SmokeTag/posture-monitoring-system/report/imt/capitulos/3metodologia.tex

\chapter{Metodologia}\label{cap:metodologia}

O sistema combina a orientação do alto das costas, medida pelo colar,
com o contato na cadeira. Esta decide o alerta e o devolve ao colar,
que vibra. O processamento independe do computador.

\section{Colar}
\label{sec:met-colar}

O colar contém uma placa XIAO nRF52840 Sense com IMU LSM6DS3TR-C
\cite{seeed_xiao,nordic_nrf52840,st_lsm6ds3trc}, posicionada nas costas,
abaixo do pescoço. Mede-se a orientação local, não a curvatura de toda a
coluna. Utiliza-se apenas o acelerômetro, com giroscópio desligado.
Das componentes $a_x$, $a_y$ e $a_z$, calculam-se \textit{pitch} ($p$)
e \textit{roll} ($r$), em graus:
\begin{equation}
 p=\frac{180}{\pi}\operatorname{atan2}\!\left(-a_x,\sqrt{a_y^2+a_z^2}\right),
 \qquad r=\frac{180}{\pi}\operatorname{atan2}(a_y,a_z).
 \label{eq:met-angulos}
\end{equation}
A estimativa usa a gravidade em condição aproximadamente estática
\cite{pedley2013}. Na montagem, $p$ é lateral (positivo à direita) e $r$,
sagital (negativo para a frente). Adquire-se e transmite-se a 20\,Hz;
movimento, deslocamento do colar e vibração podem alterar a medida.
Leituras inválidas inibem o alerta.

No circuito da Figura~\ref{fig:met-esquema-colar}, o transistor BC337
aciona o motor por modulação por largura de pulso (PWM), pois sua corrente
excede a de um pino lógico.
O diodo protege o chaveamento e o capacitor atenua o ruído. Durante os
pulsos de 700\,ms, separados por 300\,ms, transmite-se a última orientação
sem vibração, por até 1{,}5\,s. A Figura~\ref{fig:met-fluxo-colar}
sintetiza a aquisição e o controle.

\begin{figure}[H]
 \centering
 \caption{Esquema elétrico do colar.}
 \begin{SingleSpace}
 \begin{circuitikz}[font=\footnotesize, european resistors, line width=.6pt,
   pin/.style={font=\scriptsize,inner sep=2pt}]
  % XIAO do colar
  \draw[thick] (0,0) rectangle (3.8,4.0);
  \node[align=center,font=\footnotesize\bfseries] at (1.9,3.5) {XIAO nRF52840\\[-1pt] Sense};
  \draw[rounded corners=2pt] (0.45,1.45) rectangle (3.35,2.35);
  \node[align=center,font=\scriptsize] at (1.9,1.9) {IMU LSM6DS3TR-C\\(I\textsuperscript{2}C interno)};
  \node[align=center,font=\scriptsize] at (1.9,.6) {carregador\\LiPo / USB-C};
  \node[pin,anchor=west] at (0,2.7) {BAT+};
  \node[pin,anchor=west] at (0,1.0) {BAT$-$};
  \node[pin,anchor=east] at (3.8,2.9) {3V3};
  \node[pin,anchor=east] at (3.8,1.1) {D10};
  \node[pin,anchor=east] at (3.8,.4) {GND};
  % bateria
  \draw (0,2.7) to[spst,l_=S1] (-1.5,2.7) -- (-2.1,2.7) to[battery1] (-2.1,1.0) -- (0,1.0);
  \node[align=right,anchor=east,font=\scriptsize] at (-2.5,1.85) {LiPo 1S\\3{,}7\,V};
  % driver
  \node[npn,anchor=B] (Q) at (6.6,1.1) {};
  \node[font=\scriptsize,anchor=west] at (Q.text) {BC337};
  \draw (3.8,1.1) to[R,l={1\,k$\Omega$},-] (Q.B);
  \draw (Q.E) node[ground]{};
  % motor com diodo e capacitor em paralelo
  \coordinate (mb) at (Q.C |- 0,2.6);
  \coordinate (mt) at (Q.C |- 0,4.2);
  \draw (Q.C) -- (mb) to[Telmech=M] (mt);
  \draw ($(mb)+(1.2,0)$) to[D*,l_=1N4148] ($(mt)+(1.2,0)$); % cátodo no 3V3
  \draw ($(mt)+(3.1,0)$) to[C,l=33\,nF] ($(mb)+(3.1,0)$);
  \draw (mb) -- ++(3.1,0);
  \draw (3.8,2.9) -- (4.4,2.9) |- (mt) -- ++(3.1,0);
  \fill (mt) circle (1.4pt) ($(mt)+(1.2,0)$) circle (1.4pt)
        (mb) circle (1.4pt) ($(mb)+(1.2,0)$) circle (1.4pt);
  \node[font=\scriptsize,anchor=south] at (5.6,4.2) {3{,}3\,V};
  \node[font=\scriptsize,anchor=east] at ($(mb)!.5!(mt)+(-.45,0)$) {motor};
  \draw (3.8,.4) -- (4.4,.4) node[ground]{};
 \end{circuitikz}
 \end{SingleSpace}
 \fonte{Elaborado pelos autores (2026)}
 \label{fig:met-esquema-colar}
\end{figure}

\begin{figure}[H]
 \centering
 \caption{Fluxo de aquisição, controle e proteção do colar.}
 \begin{SingleSpace}
 \begin{tikzpicture}[
  b/.style={draw,rounded corners,align=center,font=\footnotesize,
    text width=3.55cm,minimum height=.78cm,inner sep=3pt},
  a/.style={-{Latex[length=1.7mm]},thick},
  n/.style={font=\footnotesize,fill=white,inner sep=1pt}]
  \node[b] (imu) at (0,0) {Ler IMU a 20\,Hz;\\reter leitura sem vibração};
  \node[b] (tx) at (4.65,0) {Enviar orientação;\\verificar ACK recebido};
  \node[b] (link) at (4.65,-1.8) {ACK de controle válido\\há menos de 1\,s?};
  \node[b] (local) at (0,-1.8) {Regra local, se calibrado:\\desvio $>10\degree{}$ por 3\,s};
  \node[b] (ack) at (9.3,-1.8) {Aplicar alerta do ACK\\se a IMU estiver válida};
  \node[b] (motor) at (4.65,-3.3) {Controlar motor\\e LED de estado};
  \node[b] (bat) at (4.65,-4.8) {Checar bateria;\\alimentar watchdog};
  \node[b] (off) at (9.3,-4.8) {Bateria baixa sem USB:\\motor e rádio OFF; desligar};
  \draw[a] (imu) -- (tx);
  \draw[a] (tx) -- (link);
  \draw[a] (link) -- node[n,above] {não} (local);
  \draw[a] (link) -- node[n,above] {sim} (ack);
  \draw[a] (local.south) |- (motor.west);
  \draw[a] (ack.south) |- (motor.east);
  \draw[a] (motor) -- (bat);
  \draw[a] (bat) -- node[n,above] {corte} (off);
  \draw[a] (bat.west) -- node[n,above] {continuar} (-2.45,-4.8) |- (imu.west);
 \end{tikzpicture}
 \end{SingleSpace}
 \fonte{Elaborado pelos autores (2026)}
 \label{fig:met-fluxo-colar}
\end{figure}

A alimentação usa LiPo 1S de 3{,}7\,V, chave S1 e recarga pelo USB-C
do XIAO; o invólucro comporta 1800\,mAh. Sem USB, três leituras abaixo de
3{,}30\,V desligam o colar; a partida exige 3{,}40\,V. O LED sinaliza
enlace, calibração, alerta e falha.

\section{Cadeira}
\label{sec:met-cadeira}

A segunda placa XIAO lê oito FSR402: quatro no assento (frente/trás,
esquerda/direita) e quatro no encosto (superior/inferior, esquerda/direita).
Sua resistência diminui com a força \cite{interlink_datasheet}; usam-se
as leituras como contato e distribuição relativa, sem conversão em força
absoluta na espuma.

O circuito da Figura~\ref{fig:met-esquema-cadeira} usa o multiplexador
CD74HC4067 \cite{ti_cd74hc4067} para ligar cada FSR ao resistor
compartilhado de 3{,}3\,k\ohm{} em SIG. Incluindo a resistência de
condução $R_{\mathrm{on}}$, a tensão lida em A0 é
\begin{equation}
 V_{\mathrm{SIG}}=V_{\mathrm{DD}}
 \frac{R_{\mathrm{fixo}}}{R_{\mathrm{fixo}}+R_{\mathrm{FSR}}+R_{\mathrm{on}}}.
 \label{eq:met-divisor}
\end{equation}
A tensão aumenta com a carga. O resistor aproxima
$\sqrt{R_{\min}R_{\max}}$ na faixa de contato, como compromisso entre
resolução e corrente; o efeito fixo de $R_{\mathrm{on}}$ é incorporado à
calibração. Os oito canais são lidos a 20\,Hz, com ADC de 12 bits.
O botão D9 solicita a calibração. A alimentação repete o circuito do colar.

\begin{figure}[H]
 \centering
 \caption{Esquema elétrico da cadeira.}
 \begin{SingleSpace}
 \begin{circuitikz}[font=\footnotesize, european resistors, line width=.6pt,
   pin/.style={font=\scriptsize,inner sep=2pt}]
  % multiplexador
  \draw[thick] (0,0) rectangle (5.4,2.9);
  \node[align=center,font=\footnotesize\bfseries] at (2.7,1.65) {CD74HC4067};
  \node[align=center,font=\scriptsize] at (2.7,1.2) {multiplexador 16:1};
  \foreach \i in {0,...,7} {
    \pgfmathtruncatemacro{\c}{\i+8}
    \coordinate (c\i) at (.55+.62*\i,2.9);
    \node[pin,anchor=north,font=\tiny] at (c\i) {C\c};
    \draw (c\i) to[R,resistors/scale=.65] ++(0,1.5) coordinate (t\i);
  }
  \node[font=\scriptsize,anchor=south] at ($(t3)!.5!(t4)+(0,.05)$) {8\,$\times$ FSR402};
  \draw (t0) -- (t7) -- ++(.9,0) coordinate (rail);
  \foreach \i in {0,...,6} \fill (t\i) circle (1.3pt);
  \node[pin,anchor=west] at (0,2.0) {VCC};
  \node[pin,anchor=west] at (0,.5) {EN};
  \node[pin,anchor=west] at (0,.15) {GND};
  \draw (0,2.0) -- (-.6,2.0) |- (t0);
   \draw (0,.5) -- (-.6,.5) -- (-.6,-.4) node[ground]{};
  \draw (0,.15) -- (-.6,.15);
  \fill (-.6,.15) circle (1.3pt);
  \foreach \n/\y in {S0/2.4,S1/1.95,S2/1.5,S3/1.05,SIG/.4}
    \node[pin,anchor=east] at (5.4,\y) {\n};
  % XIAO da cadeira
  \draw[thick] (8.9,-.8) rectangle (12.3,3.3);
  \node[align=center,font=\footnotesize\bfseries] at (10.85,2.55) {XIAO nRF52840\\[-1pt] Sense};
  \node[align=center,font=\scriptsize] at (10.9,.5) {carregador\\LiPo / USB-C};
  \foreach \n/\m/\y in {S0/D10/2.4,S1/D3/1.95,S2/D2/1.5,S3/D1/1.05} {
    \node[pin,anchor=west] at (8.9,\y) {\m};
    \draw (5.4,\y) -- (8.9,\y);
  }
  \node[pin,anchor=west] at (8.9,.4) {A0};
  \draw (5.4,.4) -- (8.9,.4);
  \fill (6.4,.4) circle (1.4pt);
  \draw (6.4,.4) to[R,l_={3{,}3\,k$\Omega$}] (6.4,-1.2) node[ground]{};
  \node[pin,anchor=north] at (9.3,3.3) {3V3};
  \draw (9.3,3.3) |- (rail);
  \node[font=\scriptsize,anchor=south] at (7.6,4.4) {3{,}3\,V};
  % botao e bateria
  \node[pin,anchor=east] at (12.3,2.2) {D9};
  \draw (12.3,2.2) -- (12.9,2.2) to[push button,l=calibrar] (12.9,.6) node[ground]{};
  \node[pin,anchor=south] at (9.6,-.8) {GND};
  \draw (9.6,-.8) -- (9.6,-1.2) node[ground]{};
  \node[pin,anchor=south] at (10.6,-.8) {BAT+};
  \node[pin,anchor=south] at (11.8,-.8) {BAT$-$};
  \draw (10.6,-.8) to[spst,l_=S1] (10.6,-2.2) to[battery1] (11.8,-2.2) -- (11.8,-.8);
  \node[font=\scriptsize,anchor=north] at (11.2,-2.55) {LiPo 1S, 3{,}7\,V};
 \end{circuitikz}
 \end{SingleSpace}
 \fonte{Elaborado pelos autores (2026)}
 \label{fig:met-esquema-cadeira}
\end{figure}

\section{Integração}
\label{sec:met-integracao}

A Figura~\ref{fig:met-arquitetura} reúne os blocos. O enlace Nordic
Enhanced ShockBurst (ESB), pela biblioteca \texttt{nrf\_to\_nrf}, usa
confirmação (ACK) e retransmissão
\cite{nordic_esb,tmrh20_nrftonrf}. A decisão da amostra $N$ retorna no ACK
de $N+1$. Após 1\,s sem ACK válido, o colar aplica a regra inercial
à última referência recebida; sem referência, não alerta.

\begin{figure}[H]
 \centering
 \caption{Arquitetura autônoma e interfaces de acompanhamento.}
 \begin{SingleSpace}
 \begin{tikzpicture}[
  b/.style={draw,rounded corners,align=center,font=\footnotesize,
   text width=3.4cm,minimum height=.8cm,inner sep=3pt},
  a/.style={-{Latex[length=1.7mm]},thick},
  n/.style={font=\footnotesize,align=center,fill=white,inner sep=2pt}]
  \node[b] (imu) at (0,0) {Acelerômetro\\LSM6DS3TR-C};
  \node[b] (body) at (4.65,0) {XIAO do colar\\aquisição e atuação};
  \node[b] (motor) at (9.3,0) {BC337 + motor\\retorno vibratório};
  \node[b] (fsr) at (0,-2.3) {8 FSR402\\+ CD74HC4067};
  \node[b] (chair) at (4.65,-2.3) {XIAO da cadeira\\calibração e fusão};
  \node[b] (pc) at (9.3,-2.3) {Painel \texttt{mostra.py}\\USB / beacon BLE};
  \draw[a] (imu) -- node[n,above] {I\textsuperscript{2}C} (body);
  \draw[a] (body) -- node[n,above] {PWM} (motor);
  \draw[a] (fsr) -- node[n,above] {ADC} (chair);
  \draw[a] (body.south west) -- node[n,left] {ESB: ângulos\\20\,Hz} (chair.north west);
  \draw[a] (chair.north east) -- node[n,right] {ACK: alerta\\e referência} (body.south east);
  \draw[a] (chair) -- (pc);
 \end{tikzpicture}
 \end{SingleSpace}
 \fonte{Elaborado pelos autores (2026)}
 \label{fig:met-arquitetura}
\end{figure}

A calibração individual é acionada com o usuário ereto, sentado ao fundo.
Em 20 amostras válidas (cerca de 1\,s), capturam-se as médias angulares
$p_0$, $r_0$ e a linha de base $b_i$ de cada FSR. Recusa-se a captura com
falha de IMU/enlace ou base traseira $B_T=b_{TE}+b_{TD}<1000$ contagens.
A referência é volátil e deve ser refeita após reinício ou recolocação.

Na fusão, $FE$, $FD$, $TE$ e $TD$ indicam frente/trás e esquerda/direita do
assento. O encosto é registrado e exibido, mas não decide o alerta, pois
pode ficar sem carga mesmo no ereto. Para leituras $f_i$, definem-se
\begin{equation}
 \begin{gathered}
 \Delta p=p-p_0,\quad \Delta r=r-r_0,\quad
 d=\sqrt{\Delta p^2+\Delta r^2},\\
 S=f_{FE}+f_{FD}+f_{TE}+f_{TD},\qquad
 \rho=\frac{f_{TE}+f_{TD}}{B_T},\\
 \ell=\frac{f_{FE}+f_{TE}-f_{FD}-f_{TD}}{S}
      -\frac{b_{FE}+b_{TE}-b_{FD}-b_{TD}}{\sum_{i\in\mathrm{assento}}b_i}.
 \end{gathered}
 \label{eq:met-indicadores}
\end{equation}
A razão $\rho$ mede o apoio traseiro relativo à referência; $\ell$, a
redistribuição lateral, positiva à esquerda. Para confirmar inclinação,
$h=\ell$ se $\Delta p<0$, ou $h=-\ell$ caso contrário; exige-se base
total do assento $\geq2000$ contagens. O teste de vazio precede as divisões.
Com $\Delta r>0$ e $\rho\geq0{,}7$, há reclinação apoiada: adota-se
$d_{\mathrm{ef}}=|\Delta p|$; nos demais casos, $d_{\mathrm{ef}}=d$.
Preserva-se assim a avaliação lateral sem alertar apenas por reclinar.
A Figura~\ref{fig:met-fusao} apresenta os testes e a persistência temporal;
são constantes de engenharia, não limites clínicos. Pernas cruzadas não
têm alerta específico; avaliam-se os desvios do tronco e o escorregamento.

Sem condição ruim, reinicia-se a contagem; na faixa de 7--10\degree{},
conserva-se o estado anterior. IMU inválida, assento vazio, perda de enlace
na cadeira e calibração aceita zeram o portão temporal. Sem USB, 10\,s de
assento vazio apagam a referência. O painel recebe o estado por USB ou
beacon BLE e exibe desvio, contato e alerta, sem participar da decisão.

\begin{figure}[H]
 \centering
 \caption{Prioridade da regra de fusão e encaminhamento ao portão temporal.}
 \begin{SingleSpace}
 \begin{tikzpicture}[y=1.12cm,
  q/.style={draw,align=center,font=\footnotesize,text width=5.3cm,
    minimum height=.65cm,inner sep=3pt},
  r/.style={draw,rounded corners,align=center,font=\footnotesize,
    text width=4.45cm,minimum height=.65cm,inner sep=3pt},
  a/.style={-{Latex[length=1.7mm]},thick},
  n/.style={font=\footnotesize,fill=white,inner sep=1pt}]
  \node[q] (invalid) at (0,0) {IMU inválida?};
  \node[q] (empty) at (0,-1.05) {$S<2000$ contagens?};
  \node[q] (slump) at (0,-2.1) {$\rho<0{,}3$?};
  \node[q] (dev) at (0,-3.15) {$d_{\mathrm{ef}}>10\degree{}$?};
  \node[q] (lean) at (0,-4.2) {Base lateral válida, $|\Delta p|\geq5\degree{}$\\e $h\geq0{,}08$?};
  \node[q] (ok) at (0,-5.35) {\texttt{RECLINE\_OK} se reclinado e $d>10\degree{}$;\\\texttt{OK} nos demais casos};
  \node[r] (ri) at (7.2,0) {\texttt{INVALID}: zerar portão};
  \node[r] (re) at (7.2,-1.05) {\texttt{EMPTY}: zerar portão};
  \node[r] (rs) at (7.2,-2.1) {\texttt{SLUMP}: condição ruim};
  \node[r] (rd) at (7.2,-3.15) {\texttt{IMU\_DEV}: condição ruim};
  \node[r] (rl) at (7.2,-4.2) {\texttt{LEAN}: condição ruim};
  \node[r] (gate) at (7.2,-5.35) {Portão: ruim por 3\,s dispara;\\sem condição ruim e $d_{\mathrm{ef}}<7\degree{}$ limpa};
  \foreach \x/\y in {invalid/empty,empty/slump,slump/dev,dev/lean,lean/ok}
    \draw[a] (\x) -- node[n,right] {não} (\y);
  \foreach \x/\y in {invalid/ri,empty/re,slump/rs,dev/rd,lean/rl}
    \draw[a] (\x) -- node[n,above] {sim} (\y);
  \draw[a] (ok) -- (gate);
  \draw[a] (rs.east) -- ++(.5,0) |- (gate.east);
  \draw (rd.east) -- ++(.5,0); \draw (rl.east) -- ++(.5,0);
 \end{tikzpicture}
 \end{SingleSpace}
 \fonte{Elaborado pelos autores (2026)}
 \label{fig:met-fusao}
\end{figure}
