SmokeTag/posture-monitoring-system/report/imt/pretextual/capa.tex

% ---
% Impressão da Capa
% ---
  \begin{capa}%
    \center
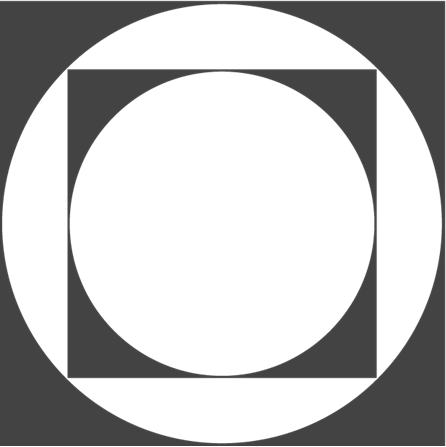
[picture p1: report/imt/images/logo_IMT_preto_1.png]
     \\
	{\fontfamily{ptm}\selectfont
        \ABNTEXchapterfont\large{CENTRO UNIVERSITÁRIO DO INSTITUTO MAUÁ DE TECNOLOGIA \\
                                        Engenharia de Controle e Automação}
    }
	
    \vspace{1cm}
    {\fontfamily{ptm}\selectfont
        \LARGE{Sistema inteligente de monitoramento postural com cadeira instrumentada e colar inercial}
    }
    \vspace{1cm}
    
    %%%%%%%%%%%%%%%%% INFORMAÇÕES SOBRE AUTOR PRINCIPAL %%%%%%%%%%%%%%%%%%%%%%%%%%%%%%%
    {\fontfamily{ptm}\selectfont
        \begin{flushright}
            \normalsize{André Thomas Monteiro} \\
            \normalsize{\pendente{demais integrantes do grupo}} \\
            \normalsize{Orientadora: Profa. \pendente{titulação} Andressa \pendente{sobrenome}} \\
        \end{flushright}
    }
    \vspace{0.2cm}

    %%%%%%%%%%%%%%%%%%%%%%%%%%%%%%%% RESUMO %%%%%%%%%%%%%%%%%%%%%%%%%%%%%%%
    
    \setlength{\absparsep}{18pt} % ajusta o espaçamento dos parágrafos do resumo
    \begin{abstract}
        \noindent
        \input{pretextual/resumo_pt}
    \end{abstract}

\end{capa}
% ---
