SmokeTag/posture-monitoring-system/report/imt/main.tex

% ---------------------------------------------------------------------------
% ---------------------------------------------------------------------------
% Modelo LaTex para preparação do documento final de Monografia TCC
% O modelo em conformidade com ABNT NBR
% IMT
% ---------------------------------------------------------------------------
% ---------------------------------------------------------------------------

\documentclass[
	% -- opções da classe memoir --
	12pt,					% tamanho da fonte
	openright,				% capítulos começam em pág ímpar (insere página vazia caso preciso)
	oneside,					% para impressão em verso e anverso. Oposto a oneside
	a4paper,					% tamanho do papel. 
	% -- opções da classe abntex2 --
	%chapter=TITLE,			% títulos de capítulos convertidos em letras maiúsculas
	%section=TITLE,			% títulos de seções convertidos em letras maiúsculas
	%subsection=TITLE,		% títulos de subseções convertidos em letras maiúsculas
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
\usepackage[alf]{abntex2cite}				% Citações padrão ABNT (alfa)

%\usepackage[num]{abntex2cite}				% Citações padrão ABNT (numericas)
% ---------------------
\usepackage{float}
% Configurações de CITAÇÕES para abntex2
%\include{extras/conf_citacoes}

% Inclui Configurações de aparência do PDF Final
\include{extras/conf_pdf}

% O tamanho da identação do parágrafo é dado por:
\setlength{\parindent}{0cm}
\setlength{\parskip}{0.2cm} 
% Controle do espaçamento entre um parágrafo e outro:
\setlength{\parskip}{0.2cm}  % tente também \onelineskip

% Ajusta o espaçamento após \chapter
\setlength\afterchapskip{\lineskip}

\setlist[itemize]{leftmargin=1.25cm}
\setlist[enumerate]{leftmargin=1.25cm}
\usepackage{listings}
\usepackage{framed}
\usepackage{color} %use color
\definecolor{mygreen}{rgb}{0,0.6,0}
\definecolor{mygray}{rgb}{0.5,0.5,0.5}
\definecolor{mymauve}{rgb}{0.58,0,0.82}
 
%Customize a bit the look.
\lstset{ %
backgroundcolor=\color{white}, % choose the background color; you must add \usepackage{color} or \usepackage{xcolor}
basicstyle=\footnotesize, % the size of the fonts that are used for the code
breakatwhitespace=false, % sets if automatic breaks should only happen at whitespace
breaklines=true, % sets automatic line breaking
captionpos=b, % sets the caption-position to bottom
commentstyle=\color{mygreen}, % comment style
deletekeywords={...}, % if you want to delete keywords from the given language
escapeinside={\%*}{*)}, % if you want to add LaTeX within your code
extendedchars=true, % lets you use non-ASCII characters; for 8-bits encodings only, does not work with UTF-8
frame=single, % adds a frame around the code
keepspaces=true, % keeps spaces in text, useful for keeping indentation of code (possibly needs columns=flexible)
keywordstyle=\color{blue}, % keyword style
% language=Octave, % the language of the code
morekeywords={*,...}, % if you want to add more keywords to the set
numbers=left, % where to put the line-numbers; possible values are (none, left, right)
numbersep=5pt, % how far the line-numbers are from the code
numberstyle=\tiny\color{mygray}, % the style that is used for the line-numbers
rulecolor=\color{black}, % if not set, the frame-color may be changed on line-breaks within not-black text (e.g. comments (green here))
showspaces=false, % show spaces everywhere adding particular underscores; it overrides 'showstringspaces'
showstringspaces=false, % underline spaces within strings only
showtabs=false, % show tabs within strings adding particular underscores
stepnumber=1, % the step between two line-numbers. If it's 1, each line will be numbered
stringstyle=\color{mymauve}, % string literal style
tabsize=2, % sets default tabsize to 2 spaces
title=\lstname % show the filename of files included with \lstinputlisting; also try caption instead of title
}
%END of listing package%
 
\definecolor{darkgray}{rgb}{.4,.4,.4}
\definecolor{purple}{rgb}{0.65, 0.12, 0.82}
 
%define Javascript language
\lstdefinelanguage{JavaScript}{
keywords={typeof, new, true, false, catch, function, return, null, catch, switch, var, if, in, while, do, else, case, break},
keywordstyle=\color{blue}\bfseries,
ndkeywords={class, export, boolean, throw, implements, import, this},
ndkeywordstyle=\color{darkgray}\bfseries,
identifierstyle=\color{black},
sensitive=false,
comment=[l]{//},
morecomment=[s]{/*}{*/},
commentstyle=\color{purple}\ttfamily,
stringstyle=\color{red}\ttfamily,
morestring=[b]',
morestring=[b]"
}
 
\lstset{
language=JavaScript,
extendedchars=true,
basicstyle=\footnotesize\ttfamily,
showstringspaces=false,
showspaces=false,
numbers=left,
numberstyle=\footnotesize,
numbersep=9pt,
tabsize=2,
breaklines=true,
showtabs=false,
captionpos=b,
aboveskip=30pt,
belowskip=0pt,
}

% ---------------------
% Compila o indice
% ---------------------
\makeindex
% ---------------------

%%%%%%%%%%%%%%%%%%%%%%%%%%%
%%  INICIO DO DOCUMENTO  %%
%%%%%%%%%%%%%%%%%%%%%%%%%%%
\begin{document}

% Retira espaço extra obsoleto entre as frases.
\frenchspacing

% ----------------------------------------------------------
% ELEMENTOS PRÉ-TEXTUAIS (Capa, Resumo, Abstract, etc.)
% ----------------------------------------------------------
\pretextual

% Elementos textuais com numeração arábica
\pagenumbering{arabic}

% Capa
\input{pretextual/capa}
\clearpage

% Resumo e Abstract
\input{pretextual/resumos}
\clearpage

% ----------------------------------------------------------
% ELEMENTOS TEXTUAIS (Capítulos)
% ----------------------------------------------------------
\textual

% Reinicia a contagem do número de páginas
\setcounter{page}{3}

% Inclui cada capitulo da Dissertação
\begingroup
    \selectlanguage{brazil}
    \renewcommand{\fontename}{Fonte} % o abstract em inglês deixa "Source"

    \renewcommand{\cleardoublepage}{}
    \renewcommand{\clearpage}{}
    
    \input{capitulos/1introducao}

    \renewcommand{\cleardoublepage}{}
    \renewcommand{\clearpage}{}
    
    \input{capitulos/2revisao_bibliografica}

    \renewcommand{\cleardoublepage}{}
    \renewcommand{\clearpage}{}
    
    \input{capitulos/3metodologia}

    \renewcommand{\cleardoublepage}{}
    \renewcommand{\clearpage}{}
    
    \input{capitulos/4resultados}

    \renewcommand{\cleardoublepage}{}
    \renewcommand{\clearpage}{}
    
    \input{capitulos/5conclusao}

\endgroup

% ----------------------------------------------------------
% ELEMENTOS PÓS-TEXTUAIS (Referências, Glossário, Apêndices)
% ----------------------------------------------------------
%\postextual

% Referências bibliográficas
\selectlanguage{brazil}
\bibliography{bibliografia}

\end{document}
