SmokeTag/posture-monitoring-system/data/archive/README.md

# Archive — midterm captures (June 2026)

> **Archived.** Midterm captures behind the partial report: the IMU
> run used a bare XIAO taped to the back (no enclosure, no neck mount) and the
> FSR402 runs a bench rig. Superseded by the full-system captures in `../`;
> kept as-is for the final report.

# Capture data — IMU posture runs

Raw serial captures from `firmware/archive/xiao_imu_test/xiao_imu_test.ino`. One CSV per
capture run. The procedure that produces these files:
[`../../docs/archive/protocolo-captura-imu.md`](../../docs/archive/protocolo-captura-imu.md).

## File naming

```
YYYY-MM-DD_<subject>_<mount>_<chair>.csv
```

- `subject` — short name (e.g. `andre`)
- `mount` — `no-neck-mount` (bare XIAO strapped on) or `neck-mount`
- `chair` — `own-chair`, `office-chair-A`, …
- Add `-run2`, `-run3` if more than one capture in a day with the same setup.

The analysis scripts default to the **newest** file here (ISO dates sort
chronologically); override with `--csv data/archive/<file>.csv`.

## Schema

`t_ms,tag,cal,pitch,roll,dpitch,droll,ax,ay,az,gx,gy,gz` — see
[`../../analysis/archive/postures.py`](../../analysis/archive/postures.py) for full column docs.

Tag map: `0` upright · `1` forward slouch · `2` lean left · `3` lean right ·
`4` head-down · `5` laid-back · `9` transition/moving (dropped in
analysis). `#`-prefixed lines are comments (calibration events, tag stamps).

## Run registry

| run | file | date | subject | mount | chair | notes |
|----:|---|---|---|---|---|---|
| 1 | `2026-06-19_andre_no-neck-mount_own-chair.csv` | 2026-06-19 | André Thomas Monteiro | none (bare XIAO) | own office chair | 6 postures × 5 rounds + 7 re-don calibrations. Validated **15 PASS / 3 WARN / 0 FAIL** (`../../analysis/archive/VALIDATION.md`). Postures performed *pronounced* → separation is optimistic. First calibration was an immediate double-press. |

# Capture data — FSR402 characterization (Campaign B)

Raw serial captures from `firmware/archive/uno_fsr_test/uno_fsr_test.ino` (Arduino Uno,
single FSR402 on a voltage divider). Procedure:
[`../../docs/archive/protocolo-fsr-balanca-precisao.md`](../../docs/archive/protocolo-fsr-balanca-precisao.md)
(precision-balance light-contact variant).

## File naming

```
YYYY-MM-DD_<sensor>_<subject>_<rfixed-ohms>_<kind>.csv
```

- `sensor` — which physical FSR402 part: `fsr` (unit 1), `fsr2`, `fsr3`, … —
  distinct sensors, for part-to-part spread.
- `rfixed-ohms` — measured divider resistor (e.g. `2833` = 2.833 kΩ measured).
- `kind` — `sweep` / `sweep2…` (R-vs-load up+down) or `creepNkg` (R-vs-time at a
  constant N-kg dead load).

## Schema

`t_ms,load_kg,raw,ohms` — `ohms = -1` means open / no force. **Units caveat:**
the column is named `load_kg` but the precision-balance runs stamp it in
**GRAMS** (`50`, `100`, … `2000`). The analysis scripts take `--units g` to
normalize. `#`-prefixed lines are comments (the CSV header, tag stamps).

## Run registry

| run | file | date | subject | R_fixed | kind | units | notes |
|----:|---|---|---|---:|---|---|---|
| B1 | `2026-06-19_fsr_andre_2833_sweep.csv` | 2026-06-19 | André Thomas Monteiro | 2833 Ω (measured) | sweep (up+down) | grams | 18 load levels 10→2004 g, ~20k loaded samples. R 4467→173 Ω; near-flat by ~1.2–1.6 kg (knee within the 2 kg cap — full saturation needs a bigger scale). **Corrected:** a ~0.3 s contact spike in the 670 g block (`t_ms` 827253–827456, ohms→613/621) was zeroed; rest of the block is clean ~314 Ω. |
| B2 | `2026-06-19_fsr_andre_2833_sweep2.csv` | 2026-06-19 | André Thomas Monteiro | 2833 Ω (measured) | sweep2 (repeat) | grams | Clean ladder 50→2002 g, ~12.6k samples. R 4134→180 Ω. Floor agrees with B1 (173 vs 180 Ω) → good repeatability. |
| B3 | `2026-06-19_fsr_andre_2833_creep1kg.csv` | 2026-06-19 | André Thomas Monteiro | 2833 Ω (measured) | creep @ 1 kg | grams | ~11 min constant 1 kg dead load. **Creep −7.4% (292→270 Ω, −0.67 %/min)**, most drift in first ~4 min. Lift-off tail at the end (still stamped 1000) excluded by the per-bin median. |
| B4 | `2026-06-19_fsr2_andre_2833_sweep.csv` | 2026-06-19 | André Thomas Monteiro | 2833 Ω (measured) | sweep (up+down), **2nd FSR** | grams | 10 levels 50→2000 g. R 3034→158 Ω. Floor agrees with FSR1 (158 vs 173/180 Ω). Part-to-part vs FSR1: ~20–40 % at the light end, ~5–10 % at the floor. **Corrected:** 17 up-sweep samples mis-stamped 100 g (`t_ms` 262993–264614, ~287 Ω — really a 1000 g reading with a dropped zero) were zeroed (load→0) to exclude them, leaving the real 100 g and 1000 g levels untouched. |
| B5 | `2026-06-19_fsr2_andre_2833_creep1kg.csv` | 2026-06-19 | André Thomas Monteiro | 2833 Ω (measured) | creep @ 1 kg, **2nd FSR** | grams | **~12 min @ 1 kg** (7118 loaded samples; `validate_fsr` PASS). Creep **−11.5 % (253→224 Ω, −0.95 %/min)** — FSR2 drifts *more* than FSR1 (B3 −7.4 %), not less. The earlier "−5.1 % / 240 Ω" was the *2-min-bin* value mistaken for the whole run. |
| B6 | `2026-06-19_fsr3_andre_2833_sweep.csv` | 2026-06-19 | André Thomas Monteiro | 2833 Ω (measured) | sweep (up+down), **3rd FSR** | grams | **Recapture of the old VOID** — now truly loaded (raw→972, floor 158 Ω). USABLE with a caveat: the light-end **up-sweep is a seating transient** (400 g up≈9 kΩ *settling* vs down 812 Ω; `validate_fsr.py` flags 600 g, up/down ×5). Trust its down-sweep / heavy end; use B7 for the clean curve. |
| B7 | `2026-06-19_fsr3_andre_2833_sweep2.csv` | 2026-06-19 | André Thomas Monteiro | 2833 Ω (measured) | sweep2 (repeat), **3rd FSR** | grams | **CLEAN** (`validate_fsr.py`: 13 PASS / 0 WARN). Well-seated 200→2001 g, R 1164→173 Ω. Floor 173 Ω agrees with FSR1/FSR2 → the **N=3 part-to-part point**. |

> **(Resolved)** The earlier *"FSR3 is VOID"* note was the first botched FSR3 try
> (puck not transferring force). FSR3 was **recaptured** into B6/B7 above; B7 is
> clean. Run `validate_fsr.py` on any new capture before trusting it.

Cross-run findings (floor, part-to-part, seating, hysteresis, model,
resolution): [`../../analysis/archive/FSR_FINDINGS.md`](../../analysis/archive/FSR_FINDINGS.md).
Tooling: [`../../analysis/archive/README.md`](../../analysis/archive/README.md).
