SmokeTag/posture-monitoring-system/docs/stand/dashboard-alerta.png

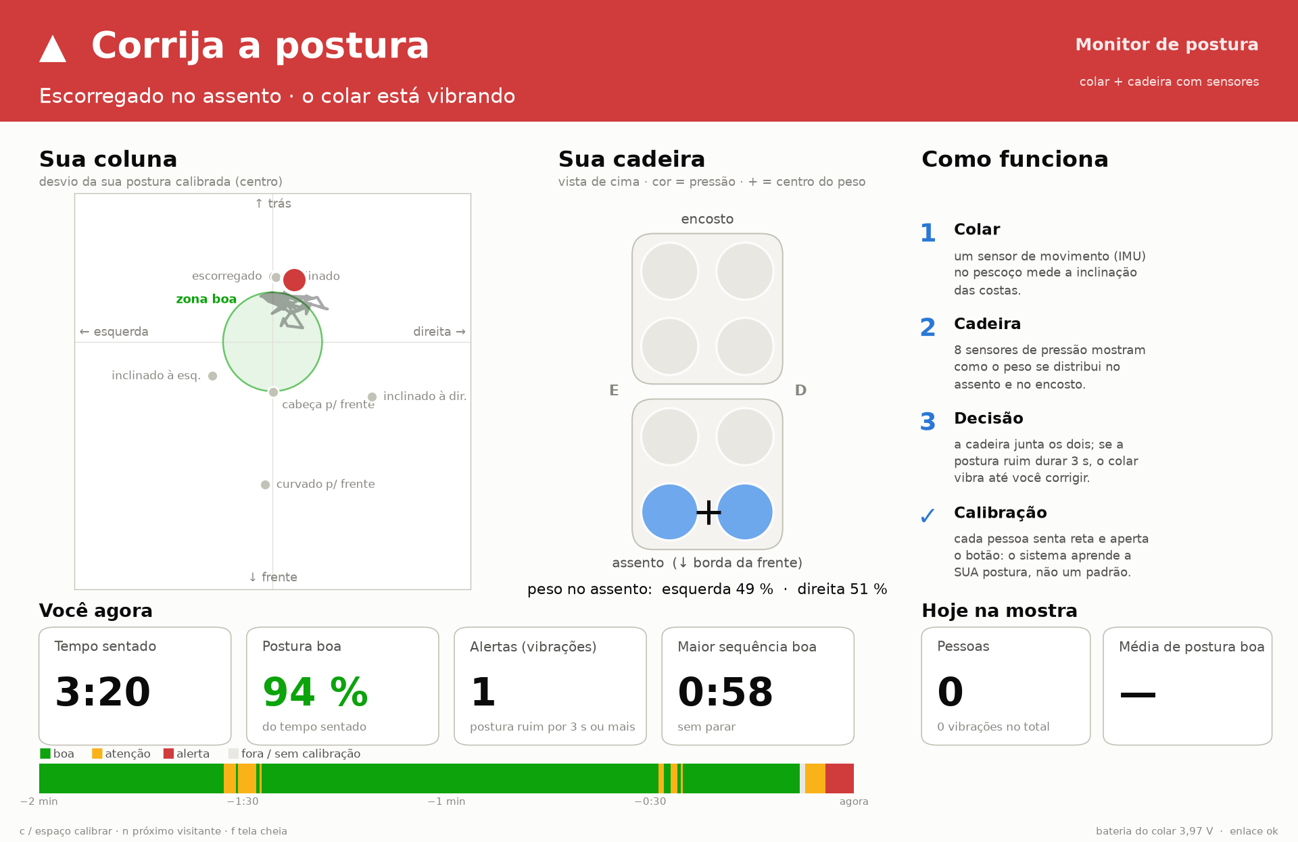
docs/stand/dashboard-alerta.png
