SmokeTag/posture-monitoring-system/docs/stand/dashboard-boa.png

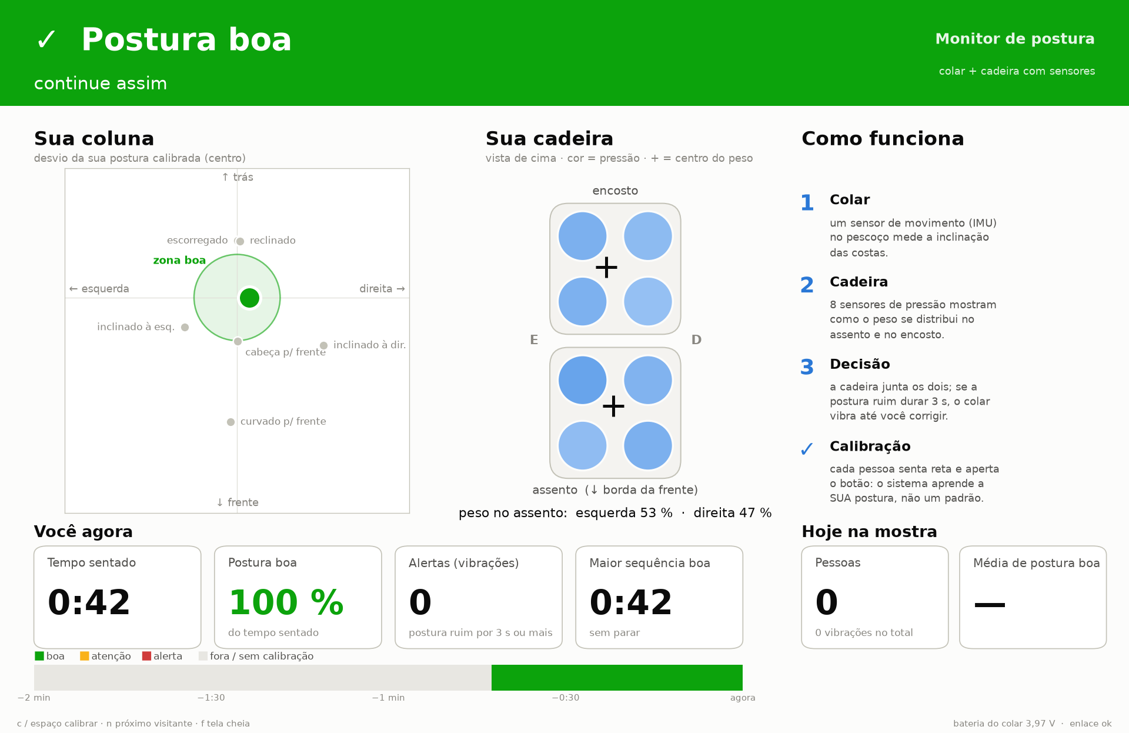
docs/stand/dashboard-boa.png
