SmokeTag/posture-monitoring-system/data/validation/2026-10-22_Andre-Monteiro_run1.csv

# validation session: Andre-Monteiro; firmware=c4ae8f2; motor active; guided hardware test; collar/chair details pending
# tag map 0=transition 1=ereto 2=curvado_frente 3=cabeca_frente 4=escorregado 5=inclinado_esq 6=inclinado_dir 7=reclinado 8=perna_e_sobre_d 9=perna_d_sobre_e
# fsr map c8=seat_front_left c9=seat_front_right c10=seat_rear_left c11=seat_rear_right c12=back_lower_right c13=back_upper_right c14=back_lower_left c15=back_upper_left
# chair unit (brain): FSRs C8..C15 + body IMU. 'c'/button = calibrate | 'r' = clear | 'm' = motor test
# unit=raw
t_ms | cal | calid | dev | alert | dpitch | droll | pitch | roll | boot | seq | bctl | bcal | bcalid | balert | bmotor | btest | bseq | bage | imu | binh | vbat | c8 | c9 | c10 | c11 | c12 | c13 | c14 | c15 | reason | tag
# proto=4
65912 | 0 | 247 | 0.0 | 0 | 2.2 | 1.3 | 2.2 | 1.3 | 231 | 1575 | 1 | 0 | 247 | 0 | 0 | 0 | 1573 | 2 | 0 | 0 | 4044 | 0 | 0 | 0 | 0 | 1 | 0 | 0 | 0 | -1 | 0
65961 | 0 | 247 | 0.0 | 0 | 2.2 | 1.3 | 2.2 | 1.3 | 231 | 1576 | 1 | 0 | 247 | 0 | 0 | 0 | 1574 | 2 | 0 | 0 | 4044 | 0 | 0 | 2 | 0 | 0 | 4 | 0 | 0 | -1 | 0
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
