SmokeTag/posture-monitoring-system/analysis/test_live_posture.py

"""Tests for live_posture.py's CSV parsing and body-status logic (no board,
no window). The main test feeds it the real chair firmware's output: the
two-board system test (firmware/test/test_system: chair.ino + body.ino on host
stubs) is built and run, and its chair serial stream is parsed line by line.

    QT_QPA_PLATFORM=offscreen .venv/bin/python -m unittest discover -s analysis
"""

from __future__ import annotations

import subprocess
import tempfile
import unittest
from pathlib import Path
from unittest.mock import Mock, patch

import numpy as np

import captures as C
import live_posture as LP

ROOT = Path(__file__).resolve().parent.parent
TESTS = ROOT / "firmware" / "test"

# firmware v1 (before the body's report): column line + rows, as captured
V1_HEADER = "t_ms,cal,dev,alert,led,dpitch,droll,pitch,roll,seq,c8,c9,c10,c11,c12,c13,c14,c15"
V1_ROWS = [
    "1000,1,3.2,0,0,1.0,-3.0,5.0,2.0,41,-1,-1,5400,-1,-1,-1,-1,-1",
    "1050,1,12.5,1,1,12.0,-3.5,16.0,1.5,42,-1,-1,5410,-1,-1,-1,-1,-1",
    "1100,0,0.0,0,0,0.0,0.0,0.0,0.0,-1,-1,-1,-1,-1,-1,-1,-1,-1",
]
V2_FIELDS = ("t_ms,cal,calid,dev,alert,dpitch,droll,pitch,roll,boot,seq,"
             "bctl,bcal,bcalid,balert,bmotor,btest,bseq,bage").split(",")


def reader() -> LP.ChairReader:
    return LP.ChairReader("/dev/null", None, trail_n=60)


def feed(r: LP.ChairReader, lines):
    for line in lines:
        r._handle(line)


def row(seq, *, boot=0x5a, cal=1, calid=7, alert=0, bctl=1, bcal=1, bcalid=7, balert=0,
        bmotor=0, btest=0, bseq=None, bage=2):
    """A v2 row dict; bseq defaults to seq - bage."""
    if bseq is None:
        bseq = (seq - bage) & 0xFFFF if bage >= 0 else -1
    return dict(t_ms=0, cal=cal, calid=calid, dev=0, alert=alert, dpitch=0, droll=0, pitch=0,
                roll=0, boot=boot, seq=seq, bctl=bctl, bcal=bcal, bcalid=bcalid, balert=balert,
                bmotor=bmotor, btest=btest, bseq=bseq, bage=bage)


class Connection(unittest.TestCase):
    def test_header_survives_open_and_reconnect_without_commands(self):
        class Port:
            def __init__(self, **kwargs):
                self.is_open, self._dtr = False, True
                self.lines, self.actions = [], []

            @property
            def dtr(self):
                return self._dtr

            @dtr.setter
            def dtr(self, value):
                self._dtr = value
                self.actions.append(("dtr", value))
                if self.is_open and value:
                    self.lines.append("# unit=raw")

            def open(self):
                self.is_open = True
                self.actions.append(("open", self.dtr))
                if self.dtr:
                    self.lines.append("# unit=raw")
                self.lines.clear()                   # pyserial's input flush during open
                self.lines.append("stale previous header")  # USB bytes arriving after that flush

            def reset_input_buffer(self):
                self.actions.append(("flush", self.dtr))
                self.lines.clear()

            def close(self):
                self.is_open = False

            def write(self, value):
                raise AssertionError("opening the port must not send commands")

        r = reader()
        with patch.object(LP.serial, "Serial", side_effect=Port), patch.object(LP.time, "sleep") as sleep:
            for _ in range(2):                      # opening and reconnecting use the same handshake
                port = r._open_port()
                self.assertEqual(port.port, r.port)
                self.assertEqual(port.actions, [("dtr", False), ("open", False),
                                                ("flush", False), ("dtr", True)])
                self.assertEqual(port.lines, ["# unit=raw"])
                port.close()
            self.assertEqual(sleep.call_count, 2)

    def test_failed_open_closes_port(self):
        port = Mock()
        port.open.side_effect = LP.serial.SerialException("device disappeared")
        with patch.object(LP.serial, "Serial", return_value=port):
            with self.assertRaises(LP.serial.SerialException):
                reader()._open_port()
        port.close.assert_called_once()


    def test_motor_muted_sends_q_on_every_connection(self):
        """--motor-muted: 'q' right after each (re)connection (the chair
        unmutes whenever the port closes); without it, nothing is sent."""
        class Stop(Exception):
            pass

        for muted, expected in ((True, [b"q", b"q"]), (False, [])):
            writes = []

            class Port:
                def __enter__(self):
                    return self

                def __exit__(self, *exc):
                    return False

                def write(self, value):
                    writes.append(value)

                def readline(self):
                    raise LP.serial.SerialException("unplugged")

            r = LP.ChairReader("/dev/null", None, trail_n=60, motor_muted=muted)
            with patch.object(r, "_open_port", side_effect=lambda: Port()), \
                    patch.object(LP.time, "sleep", side_effect=[None, Stop()]):
                with self.assertRaises(Stop):
                    r.run()
            self.assertEqual(writes, expected)


class MotorMute(unittest.TestCase):
    """The motor line with the body's bmute report (protocol v5)."""

    def motor(self, **kw):
        r = row(100)
        r.update(kw)
        return LP.body_lines([r])[2]

    def test_lines(self):
        self.assertEqual(self.motor(bmute=1), "motor   ○ mudo")
        self.assertEqual(self.motor(bmute=1, bmotor=1, balert=1), "motor   ○ mudo (teria vibrado)")
        self.assertEqual(self.motor(bmute=1, bmotor=1, btest=1), "motor   ● teste")   # really buzzes
        self.assertEqual(self.motor(bmute=0, bmotor=1, balert=1), "motor   ● alerta")
        self.assertEqual(self.motor(bmotor=1, balert=1), "motor   ● alerta")          # v4: no bmute


class RealFirmwareStream(unittest.TestCase):
    """The chair stream of firmware/test/test_system, through ChairReader."""

    @classmethod
    def setUpClass(cls):
        subprocess.run(["make", "-s", "-C", str(TESTS), "test_system"], check=True,
                       capture_output=True)
        with tempfile.TemporaryDirectory() as d:
            chair, body = Path(d) / "chair.out", Path(d) / "body.out"
            subprocess.run([str(TESTS / "test_system"), str(chair), str(body)], check=True,
                           capture_output=True)
            cls.lines = chair.read_text().splitlines()

    def test_header_drives_columns(self):
        r = reader()
        feed(r, self.lines)
        self.assertEqual(r.fields, V2_FIELDS + ["imu", "binh", "vbat"])
        self.assertTrue(r.rows)
        self.assertEqual(len(r.fsr[-1][1]), 8)          # c8..c15 found after the new columns

    def test_every_body_report_confirms(self):
        """Replays the stream; at every row the status is computed as the
        live view would. The system is consistent, so: never "≠"; ✓ in steady
        chair control; fallback and unknown bases never count as a mismatch."""
        r = reader()
        seen = {"✓ aplicado": 0, "não conferido": 0, "SOZINHO": 0, "≠ aplicado": 0}
        for line in self.lines:
            n0 = len(r.rows)
            last = r.rows[-1] if r.rows else None
            r._handle(line)
            if not r.rows or (len(r.rows) == n0 and r.rows[-1] is last):
                continue
            text = " ".join(LP.body_lines(list(r.rows))[:2])
            for k in seen:
                seen[k] += k in text
        self.assertEqual(seen["≠ aplicado"], 0)
        self.assertGreater(seen["✓ aplicado"], 200)
        self.assertGreater(seen["SOZINHO"], 50)
        self.assertGreater(seen["não conferido"], 0)       # e.g. the chair's no-basis ACK

    def test_motor_test_is_not_an_alert(self):
        r = reader()
        tested = False
        for line in self.lines:
            r._handle(line)
            if r.rows and r.rows[-1].get("btest") == 1:
                self.assertEqual(LP.body_lines(list(r.rows))[2], "motor   ● teste")
                self.assertEqual(r.rows[-1]["balert"], 0)
                tested = True
        self.assertTrue(tested)


    def test_log_gets_the_tag_column(self):
        """The logged stream reads back as one table with a trailing tag column,
        holding the tag in effect when each row arrived (0 until one is set)."""
        with tempfile.TemporaryDirectory() as d:
            path = Path(d) / "run.csv"
            r = LP.ChairReader("/dev/null", path, trail_n=60)
            r.note("tag map 0=transition 1=upright")
            half = len(self.lines) // 2
            feed(r, self.lines[:half])
            r.tag = 3
            feed(r, self.lines[half:])
            r.log.close()
            table = [ln.split(",") for ln in path.read_text().splitlines()
                     if not ln.startswith("#")]
        header, data = table[0], table[1:]
        self.assertEqual(header[-1], "tag")
        self.assertTrue(data)
        self.assertTrue(all(len(x) == len(header) for x in data))
        tags = [x[-1] for x in data]
        self.assertEqual(tags[0], "0")
        self.assertEqual(tags[-1], "3")
        self.assertEqual(sorted(set(tags)), ["0", "3"])


    def test_battery_reported(self):
        """The system test's body runs at ~3.9 V (host stub): every body row
        carries it, body-silent rows carry -1 (not shown as a reading)."""
        r = reader()
        feed(r, self.lines)
        self.assertTrue(all(abs(x["vbat"] - 3899) <= 2 for x in r.rows))
        self.assertEqual(LP.battery_text(r.rows[-1]), "bateria 3,90 V")


class Battery(unittest.TestCase):
    def test_text(self):
        self.assertEqual(LP.battery_text(row(1)), "bateria ? (firmware antigo)")
        self.assertEqual(LP.battery_text({**row(1), "vbat": 0}), "bateria — sem leitura ainda")
        self.assertEqual(LP.battery_text({**row(1), "vbat": 3712}), "bateria 3,71 V")
        self.assertEqual(LP.battery_text({**row(1), "vbat": 3310}), "bateria 3,31 V  BAIXA (desliga < 3,30 V)")

    def test_cutoff_hint_when_silent(self):
        self.assertEqual(LP.cutoff_hint([]), "")
        self.assertEqual(LP.cutoff_hint([row(1)]), "")                     # old firmware
        self.assertEqual(LP.cutoff_hint([{**row(1), "vbat": 3800}]), "")
        self.assertIn("3,31 V: desligou por bateria baixa?", LP.cutoff_hint([{**row(1), "vbat": 3310}]))


class OldFirmware(unittest.TestCase):
    def test_v1_with_header(self):
        r = reader()
        feed(r, [V1_HEADER] + V1_ROWS)
        self.assertEqual(r.fields, LP.FIELDS)
        self.assertEqual([x["seq"] for x in r.rows], [41, 42])
        self.assertFalse(r.body_up)                     # last row: seq -1
        self.assertEqual(LP.body_lines(list(r.rows)),
                         ["corpo   (firmware antigo)", "        sem relatório", "motor   ● ligado"])
        self.assertEqual(r.fsr[-2][1][10], LP.M.ohms_to_us(5410))

    def test_v1_without_header(self):
        """No header seen (e.g. a log started mid-stream): v1 layout assumed."""
        r = reader()
        feed(r, V1_ROWS[:2])
        self.assertEqual(r.rows[-1]["led"], 1)

    def test_header_change_drops_old_rows(self):
        r = reader()
        feed(r, [V1_HEADER] + V1_ROWS[:2])
        feed(r, [",".join(V2_FIELDS + [f"c{c}" for c in LP.M.CHANNELS])])
        self.assertEqual(len(r.rows), 0)


class Confirmation(unittest.TestCase):
    """When body_lines() may say ✓ / ≠, and when only "não conferido"."""

    def stream(self, n=10, **kw):
        return [row(s, **kw) for s in range(100, 100 + n)]

    def check(self, rows):
        return LP.body_lines(rows)[1].strip()

    def test_steady_state(self):
        self.assertEqual(self.check(self.stream()), "✓ aplicado")
        self.assertEqual(LP.body_lines(self.stream())[0], "corpo   cadeira, idade 2")

    def test_mismatch(self):
        rows = self.stream()
        rows[-3]["alert"] = 1                           # decided alert, body reports none
        self.assertEqual(self.check(rows), "≠ aplicado")
        rows = self.stream()
        rows[-3]["calid"] = 8                           # another reference
        self.assertEqual(self.check(rows), "≠ aplicado")

    def test_unknown_basis_or_saturated_age(self):
        for kw in (dict(bage=-1), dict(bage=254, bseq=5)):
            rows = self.stream()
            rows[-1] = row(109, **kw)
            self.assertEqual(self.check(rows), "não conferido")
        self.assertEqual(LP.body_lines(self.stream()[:-1] + [row(109, bage=254, bseq=5)])[0],
                         "corpo   cadeira, idade 254+")

    def test_decision_not_in_buffer(self):
        self.assertEqual(self.check([row(100)]), "não conferido")

    def test_other_session_never_matches(self):
        rows = self.stream()
        for x in rows[:-1]:
            x["boot"] = 0x11                            # same seqs, other body boot
            x["alert"] = 1
        self.assertEqual(self.check(rows), "não conferido")

    def test_seq_going_back_stops_the_search(self):
        rows = [row(s) for s in (105, 106, 107)] + [row(s) for s in (100, 101, 102)]
        rows[1]["alert"] = 1                            # seq 106 "decided" an alert, earlier
        rows[-1] = row(108, bage=2)                     # bseq 106, but seq went back before it
        self.assertEqual(self.check(rows), "não conferido")

    def test_seq_wrap(self):
        rows = [row(s & 0xFFFF) for s in range(65530, 65538)]
        self.assertEqual(rows[-1]["bseq"], 65535)
        self.assertEqual(self.check(rows), "✓ aplicado")

    def test_fallback_is_not_a_mismatch(self):
        rows = self.stream(bctl=2, balert=1, bage=60)   # its own alert, chair says none
        self.assertEqual(LP.body_lines(rows)[:2], ["corpo   SOZINHO (sem enlace)", "        ref = da cadeira"])
        rows[-1]["bcalid"] = 9
        self.assertEqual(self.check(rows), "ref ≠ da cadeira")

    def test_none_yet(self):
        rows = [row(0, bctl=0, bcal=0, bcalid=0, bage=-1)]
        self.assertEqual(LP.body_lines(rows)[0], "corpo   sem decisão da")


class ImuHealth(unittest.TestCase):
    @classmethod
    def setUpClass(cls):
        RealFirmwareStream.setUpClass()

    def test_old_firmware_health_is_unknown(self):
        self.assertEqual(LP.imu_text(row(10)), "IMU ? (firmware antigo)")
        self.assertTrue(LP.imu_valid(row(10)))          # historical posture data remains readable

    def test_invalid_sample_has_no_confirmation(self):
        rows = [row(s) for s in range(100, 110)]
        for code in range(1, 5):
            rows[-1]["imu"] = code
            self.assertFalse(LP.imu_valid(rows[-1]))
            self.assertNotIn("✓", " ".join(LP.body_lines(rows)))
            self.assertNotEqual(LP.imu_text(rows[-1]), "IMU OK")

    def test_inhibited_decision_is_explicit_not_a_mismatch(self):
        rows = [row(s) for s in range(100, 110)]
        rows[-3]["alert"] = 1
        rows[-1].update(imu=0, binh=1, balert=0)
        self.assertEqual(LP.body_lines(rows)[1].strip(), "proteção IMU (inibido)")
        rows[-1]["bcalid"] = 8
        self.assertEqual(LP.body_lines(rows)[1].strip(), "≠ aplicado")

    def test_real_stream_contains_invalid_and_inhibited_samples(self):
        r = reader()
        invalid, inhibited = 0, 0
        for line in RealFirmwareStream.lines:
            r._handle(line)
            if r.rows and "imu" in r.rows[-1]:
                invalid += not LP.imu_valid(r.rows[-1])
                inhibited += r.rows[-1].get("binh", 0) == 1
        self.assertGreater(invalid, 20)
        self.assertGreater(inhibited, 0)


class Parsing(unittest.TestCase):
    def test_raw_fsr_conversion_and_legacy_units(self):
        r = reader()
        header = ",".join(V2_FIELDS + [f"c{c}" for c in LP.M.CHANNELS])
        sample = ",".join(str(v) for v in row(100).values())
        feed(r, ["# unit=raw", header, sample + ",0,7,8,1365,2048,4094,0,0"])
        loads = r.fsr[-1][1]
        self.assertEqual(loads[8], 0)
        self.assertEqual(loads[9], 0)                  # below the open-FSR threshold
        self.assertGreater(loads[10], 0)
        self.assertAlmostEqual(loads[11], 1e6 / 6600) # raw 1365 = 1/3 full scale
        self.assertGreater(loads[12], loads[11])
        self.assertGreater(loads[13], loads[12])
        feed(r, ["# unit=ohms (-1 = open)", header, sample + ",6600,-1,-1,-1,-1,-1,-1,-1"])
        self.assertAlmostEqual(r.fsr[-1][1][8], loads[11])

    def test_header_fields(self):
        cols = V2_FIELDS + [f"c{c}" for c in LP.M.CHANNELS]
        self.assertEqual(LP.header_fields(",".join(cols)), V2_FIELDS)

    def test_parse_row_rejects_junk(self):
        self.assertIsNone(LP.parse_row("# rx pkts=1", V2_FIELDS))
        self.assertIsNone(LP.parse_row("1,2,3", V2_FIELDS))
        self.assertIsNone(LP.parse_row("12,a" + ",0" * 30, V2_FIELDS))

    def test_columns_after_the_fsrs_go_into_the_row(self):
        head = ",".join(V2_FIELDS + [f"c{c}" for c in range(8, 16)] + ["reason", "tag"])
        tail = LP.tail_fields(head)
        self.assertEqual(tail, ["reason", "tag"])
        line = "12," + ",".join(["0"] * (len(V2_FIELDS) - 1)) + ",1,2,3,4,5,6,7,8,3,0"
        r, fsr = LP.parse_row(line, V2_FIELDS, tail)
        self.assertEqual(fsr, [1, 2, 3, 4, 5, 6, 7, 8])
        self.assertEqual((r["reason"], r["tag"]), (3, 0))

    def test_rx_summary_shows_bad(self):
        s = LP.rx_summary("rx pkts=0 lost=0 dup=0 old=0 rst=0 bad=20 sdrop=0 edrop=0 dt=1000")
        self.assertEqual(s, "rx pkts=0 lost=0 bad=20")


class TagClock(unittest.TestCase):
    def test_transition_is_a_stopwatch(self):
        self.assertEqual(LP.tag_clock(0, 0.4), ("⏱ 0:00", False))
        self.assertEqual(LP.tag_clock(0, 75.2), ("⏱ 1:15", False))

    def test_posture_counts_down_then_done(self):
        self.assertEqual(LP.tag_clock(2, 0.0), ("⏳ 15 s", False))
        self.assertEqual(LP.tag_clock(2, 14.2), ("⏳ 1 s", False))
        self.assertEqual(LP.tag_clock(2, 15.0), ("✓ pronto", True))
        self.assertEqual(LP.tag_clock(2, 0.0, hold=20), ("⏳ 20 s", False))

    def test_upright_between_postures_is_shorter(self):
        self.assertEqual(LP.tag_clock(1, 0.0), ("⏳ 10 s", False))


class Reference(unittest.TestCase):
    def test_recorded_postures_land_where_the_neck_mount_puts_them(self):
        """dpitch = sideways, droll = forward/back (the axis labels rely on it)."""
        runs = LP.load_reference_runs()
        if not runs:
            self.skipTest("no captures in data/")
        med = {k: np.median(v, axis=0) for k, v in LP.reference_points(runs).items()}
        self.assertLess(med["curvado"][1], -10)          # slouch: droll forward
        self.assertGreater(med["reclinado"][1], 5)       # recline: droll back
        self.assertLess(med["esq"][0], -5)               # lean left: dpitch −
        self.assertGreater(med["dir"][0], 5)             # lean right: dpitch +
        self.assertLess(np.hypot(*med["pernas"]), 7)     # crossed legs: inside the clear circle

    def test_one_dot_per_subject(self):
        runs = LP.load_reference_runs()
        if not runs:
            self.skipTest("no captures in data/")
        n = len({r.subject for r in runs})
        self.assertLess(n, len(runs))                    # André has two runs
        self.assertEqual(len(LP.reference_points(runs)["curvado"]), n)

    def test_broken_or_active_log_is_skipped(self):
        with tempfile.TemporaryDirectory() as tmp:
            data = Path(tmp)
            good = sorted(C.DATA.glob(LP.REF_GLOB))[0]
            (data / good.name).write_text(good.read_text())
            (data / "2026-10-21_Empty_run1.csv").write_text("# tag map 0=transition\n")
            (data / "2026-10-21_HeaderOnly_run1.csv").write_text("# x\nt_ms,cal\n")
            active = data / "2026-10-21_Active_run1.csv"
            active.write_text(good.read_text())
            with patch.object(C, "DATA", data), patch("builtins.print"):
                runs = LP.load_reference_runs(skip=active)
            self.assertEqual([r.path.name for r in runs], [good.name])


if __name__ == "__main__":
    unittest.main()
