SmokeTag/posture-monitoring-system/(commit log)

2026-06-18 Initial commit: posture monitoring system (TCC)
    Wearable + instrumented-chair posture detector. Snapshot of work so far:
    - CLAUDE.md: full project context (hardware, data flow, decisions, open
    questions, bring-up plan).
    - firmware/xiao_imu_test: XIAO nRF52840 Sense IMU bring-up (verified working).
    - firmware/uno_fsr_test: Arduino Uno single-FSR402 characterization sketch.
    - docs/decisao-calibracao-vs-limiar-absoluto.md: calibration-vs-absolute-
    threshold rationale (PT-BR).
    - INTRODUÇÃO_TCC.pdf: paper introduction draft.
2026-06-19 docs: add midterm measurement plan + status pointer
    Register the two-campaign bench-characterization plan (IMU posture +
    FSR402 load) for the midterm partial report, with mapping to the TCC
    objectives from INTRODUÇÃO_TCC.pdf. Point CLAUDE.md Status at it.
2026-06-19 firmware: CSV posture logging (XIAO) + 6-channel FSR array (Uno)
    xiao_imu_test: add a CSV logging mode ('l' toggles) that streams one
    machine-parsable row per sample (t_ms,tag,cal,pitch,roll,dpitch,droll,
    ax,ay,az,gx,gy,gz) at 20 Hz, with '0'-'9' tagging postures/trials and
    '#'-prefixed prose so a tee'd capture parses directly. Existing pitch/
    roll + 'c' calibration behaviour unchanged in the live view.
    uno_fsr6_test: new sketch reading six FSR402 dividers on A0-A5 (no mux)
    and logging resistance per channel as CSV for the seat weight-distribution
    map. Single-FSR uno_fsr_test kept for the R-vs-load characterization.
    Both compile clean (XIAO 6% flash; Uno 11% flash / 17% RAM).
    Co-Authored-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
2026-06-19 docs: document junk-tag 9 (exclude transitions) in IMU capture protocol
    Reserve tag 9 for moving/transition samples in xiao_imu_test and the
    measurement plan: transitions corrupt posture data twice (angle sweeps
    through in-between values; the accelerometer reads motion + gravity so
    the tilt math is briefly wrong). Press 9 on every transition and drop
    tag==9 rows in analysis. Comment/doc only — no behaviour change.
    [xiao_imu_test.ino]
2026-06-19 analysis: validation + plotting tooling for IMU posture captures
    Add analysis/ to validate and visualise the posture captures from
    firmware/xiao_imu_test (CSV: t_ms,tag,cal,pitch,roll,dpitch,droll,
    ax,ay,az,gx,gy,gz).
    - postures.py shared loader + helpers (load, steady, segments,
    accel_magnitude, recompute_angles, deviation,
    calibration_epochs, parse_calibration_comments) + tag map
    - validate_postures.py re-runnable PASS/WARN/FAIL report (parse, timing,
    calibration logic, sensor health, protocol/separability);
    exits non-zero only on FAIL
    - plot_postures.py 6 figures (timeline, separability raw vs calibrated,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
    [plot_postures.py, postures.py, validate_postures.py]
2026-06-19 data: version raw IMU captures under data/ + run registry
    Move the first posture capture into data/ with a date-stamped,
    descriptive name and add a run registry (data dictionary, naming
    convention YYYY-MM-DD_subject_mount_chair, per-run metadata).
    Run 1: André Thomas Monteiro, bare XIAO (no neck mount), own office
    chair — 6 postures x 5 rounds + 7 re-don calibrations.
    Claude-Session: https://claude.ai/code/session_01L9YvxEiHeeMo7oWTMhHFsy
    [2026-06-19_andre_no-neck-mount_own-chair.csv]
2026-06-19 docs: identify tag 5 (reclined) + add repeatable IMU capture protocol
    Tag 5 turned out to be a real, deliberate 6th posture (reclined /
    laid-back: hips forward, torso back — the highest pitch). Add it to the
    tag map in the firmware header, the midterm plan, and postures.py, and
    note the pitch convention (forward = low pitch, back = high).
    - docs/protocolo-captura-imu.md: standalone SOP to repeat Campaign A
    (with the neck mount and other subjects), incl. metadata/naming,
    capture sequence, re-don experiment, and the validate/plot step.
    - plano-medicoes-midterm.md: tag 5 in the map + sequence; check off the
    captured/reduced items; add the subtler-postures follow-up.
    - CLAUDE.md: Campai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
2026-06-19 analysis: rename tag 5 to "Laid-back" + fix timeline legend overlap
    - Tag 5 label shortened from "Reclined (laid-back)" to "Laid-back" to
    match the other short posture names; propagated everywhere.
    - 01_timeline.png: lower the legend and raise the title pad so the title
    no longer sits behind the legend.
    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
    [plot_postures.py, postures.py, xiao_imu_test.ino]
2026-06-19 firmware+analysis: FSR402 R-vs-load capture path (Campaign B)
    Enable measuring the FSR resistance-vs-force curve to find the
    saturation knee.
    - uno_fsr_test: add CSV/load-stamp mode ('l' toggles; type the bathroom-
    scale reading in kg to stamp load_kg). Logs t_ms,load_kg,raw,ohms with
    '#' comments, same capture pattern as the IMU sketch. Compiles for
    arduino:avr:uno (21% flash).
    - analysis/plot_fsr_curve.py: R-vs-load curve (linear + log), median per
    load level, auto saturation-knee + floor, force-in-N secondary axis.
    - docs/protocolo-caracterizacao-fsr.md: standalone procedure (wiring,
    scale+puck sweep, plotting, divider-resistor choice).
    - Cross-links in analysis/README, CLAUDE.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
2026-06-19 docs: Claude owns git commits for this repo
    Working agreement: when André asks to commit or signals he doesn't want to
    think about it, Claude stages and writes the commit itself — commit-to-main,
    grouped by intent, never committing botched/void data.
2026-06-19 analysis+firmware+docs: FSR402 light-contact capture path
    - firmware: R_FIXED = 2833 (measured), not nominal 3.3k
    - plot_fsr_curve.py: --units g (precision-balance protocol stamps grams)
    - plot_fsr_creep.py: new R-vs-time creep plot, robust to lift-off tail
    - docs: precision-balance (<=2 kg) light-contact protocol variant
2026-06-19 data: Campaign B FSR402 captures (FSR1, FSR2) + registry
    FSR1: 2 sweeps + 10-min creep. FSR2: 1 sweep + short creep.
    Findings: ~160-180 Ohm floor, knee above 2 kg (saturates), part-to-part
    20-40% (light) -> 5-10% (floor), hysteresis up to -76% at light touch.
    FSR3 sweep left out (void capture: sensor never loaded) - see registry.
    [2026-06-19_fsr2_andre_2833_creep1kg.csv, 2026-06-19_fsr2_andre_2833_sweep.csv, 2026-06-19_fsr_andre_2833_creep1kg.csv, 2026-06-19_fsr_andre_2833_sweep.csv, 2026-06-19_fsr_andre_2833_sweep2.csv]
2026-06-20 data: FSR3 captures (B6/B7) + verified-number registry corrections
    Add the FSR3 sweeps (B6 seating-compromised up-sweep, B7 clean N=3 point)
    and update the Campaign B registry. Corrects two numbers caught by the
    midterm review and re-verified from raw:
    - B5 (FSR2) creep is a full ~12 min run, -11.5% (253->224 ohm), not the
    2-min/-5.1% misread; FSR2 drifts more than FSR1, not less.
    - part-to-part @1 kg is ~46% (290/267/391, one consistent direction rule),
    not the ~5% up-sweep cherry-pick; floor onset softened to ~1.6-2 kg.
    Reframes the 3-11x seating swing as a bench rigid-puck transient that
    motivates (not mandates) per-user calibration.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
    [2026-06-19_fsr3_andre_2833_sweep.csv, 2026-06-19_fsr3_andre_2833_sweep2.csv]
2026-06-20 analysis: FSR402 characterization tooling (lib + validator + figures)
    Shared fsr_lib.py (robust loader, load-jitter merge, up/down split,
    power/conductance fit, run discovery) plus validate_fsr.py (PASS/WARN/FAIL
    capture gate) and the figure scripts: part-to-part, hysteresis, response
    model/resolution, and the updated R-vs-load curve.
    [fsr_lib.py, plot_fsr_curve.py, plot_fsr_hysteresis.py, plot_fsr_model.py, plot_fsr_parttopart.py, validate_fsr.py]
2026-06-20 analysis: Campaign B findings + midterm project review (corrected)
    FSR_FINDINGS.md (multi-lens FSR evaluation) and verified corrections to
    VALIDATION.md: re-don drift recomputed from steady tag==0 holds = 8.0 deg
    pitch / 21.6 deg roll across n=4 genuine re-dons, replacing the earlier
    false "21 deg inflated by junk" note; bad-posture p05 clarified as pooled.
    PROJECT_REVIEW.md captures the multi-agent review (verdict, numeric
    corrections, examiner risks, prioritized actions).
2026-06-20 docs: reframe OE2/OE4 to per-channel viability + defer integration/OE3
    Midterm plan now states the parcial characterizes each sensing channel in
    isolation (evidence toward viability), explicitly deferring integration,
    fusion, efficiency evaluation, and OE3; no inferential statistics claimed
    at N=1 subject / N=3 sensors.
2026-06-20 report: ABNT figure/table captions (Figura N – Título acima, Fonte abaixo)
    Set the caption separator to en-dash (\captionsetup{labelsep=endash}) so
    captions render "Figura N – ..." / "Tabela N – ..."; move each figure title
    ABOVE the image; add a \fonte macro that prints "Fonte: ..." in smaller type
    BELOW each figure/table. Matches Brazilian academic (ABNT) convention.
2026-06-20 analysis: re-don figure uses n=4 genuine epochs (8.0°/21.6°)
    The re-don drift figure plotted all 7 calibration presses from the
    firmware-snapshot reference (pitch-dpitch), embedding a "7.7°/21.4°" title
    that contradicted the report's prose (8.0°/21.6° across the 4 genuine
    re-don epochs). Add postures.redon_upright_refs(): the upright reference as
    the mean absolute pitch/roll over each genuine epoch's steady tag==0 hold,
    dropping the 3 immediate double-presses (tag==9 junk). fig_redon now plots
    those 4 points and labels n; regenerated 04_redon_drift.png matches the
    report.
    [plot_postures.py, postures.py]
2026-06-20 report: fix factual errors, complete citations, tighten framing
    Audit fixes before human validation:
    - separation floor "≥22°" → "≥21,7°" (abstract + Results): the 2nd-closest
    pair (upright↔head-down) is 21.76°, so ≥22° was false as written.
    - ROSA correctly attributed to Sonne, Villalta & Andrews (2012) — was
    "Song e Qu (2014)" (body + reference entry).
    - bibliography completed (verified, not fabricated): Okezue 2020, Mohammadian
    2025, Robertson/Ciriello/Garabet 2013, ROSA, Iida & Guimarães. BackWatch
    (Ferreira 2023) still [completar] — could not verify the source.
    - Iida co-author corrected Buarque → Guimarães (L. B. M.).
    - "sem deriva" reworded: static accel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
2026-06-20 docs: sync OE1 re-don numbers to 8.0°/21.6° (n=4 genuine)
    Two stale lines still said 7.7° / 7 re-dons, now contradicting the
    regenerated figure and the report. Align to 8.0° pitch / 21.6° roll across
    the 4 genuine re-don epochs.
2026-06-20 report: precise FSR curve wording + ABNT figure sources
    Per author feedback:
    - Drop the misleading "saturação"/"joelho" framing. The ~1,2 kg point is the
    elbow of the *measured* 0–2 kg curve (most of the R drop happens below it),
    not sensor saturation — the FSR402 is rated ~10 kg and was only loaded to
    2 kg, with R still descending at the cap. Reworded precisely (abstract,
    paragraph, caption) so no explicit "not saturation" disclaimer is needed.
    Saturation now appears only in Próximas etapas as unmeasured future work.
    fsr_curve.png regenerated: figure text softened to match ("R flattens at
    higher load, low resolution when seated"), no "saturates" claim.
    - Figure/table "F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
2026-06-20 data: zero mis-stamped / spike samples in FSR1 & FSR2 sweeps
    Author corrections, re-applied cleanly (the originals were briefly round-tripped
    through LibreOffice, which reformatted every row 0.00->0 and CRLF->LF; restored
    from HEAD and replayed only the intended edits, preserving CRLF and 0.00):
    - FSR1 sweep (B1): 48 rows of the 670 g block tail (t_ms 826038-830799 — the
    contact spike at 827253/827355 plus a margin before/after) set load->0.00 to
    exclude them.
    - FSR2 sweep (B4): 17 up-sweep rows mis-stamped 100 g (t_ms 262993-264614,
    really a 1000 g reading with a dropped zero) set load->0.00.
    Only the load field changed (raw/ohms untouched); validate_fsr verdict unchanged
    on both fi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
    [2026-06-19_fsr2_andre_2833_sweep.csv, 2026-06-19_fsr_andre_2833_sweep.csv]
2026-06-20 report: ABNT formatting pass on relatório parcial
    Bring the partial report in line with the core ABNT norms:
    - NBR 14724: margens 3/2/2/2 cm, entrelinhas 1,5 (setspace), fonte Times
    (mathptmx) e recuo de primeira linha 1,25 cm (indentfirst), no lugar do
    estilo de bloco com lmodern e margens uniformes de 2,5 cm.
    - NBR 6028: adiciona Palavras-chave ao final do resumo (estava ausente).
    - NBR 6023: referências reformatadas para o padrão alinhado à esquerda,
    espaço simples por entrada com espaço entre elas e sobrenome em caixa
    alta na linha (em vez da lista description); destaque apenas no título
    principal (subtítulo sem itálico) e McATAMNEY -> MCATAMNEY.
    - Tabela de variaçã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
2026-06-21 docs: remove superseded midterm plan, repoint its inbound links
    plano-medicoes-midterm.md was planning scaffolding whose substantive
    content has been promoted into the partial report, the capture SOPs, and
    data/README.md. Its only unique detail (why tag 9 contaminates data twice)
    is moved into protocolo-captura-imu.md before removal.
    Repoint the 7 inbound references so none dangle:
    - CLAUDE.md -> report + data/README.md + the two SOPs
    - protocolo-{captura-imu,caracterizacao-fsr}.md -> the partial report
    - VALIDATION.md, postures.py (tag map) -> data/README.md
    - xiao_imu_test.ino -> protocolo-captura-imu.md
    - uno_fsr6_test.ino -> protocolo-caracterizacao-fsr.md (6-channel weight map)
    Co-Aut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
2026-09-15 docs: mark calibration-vs-absolute-threshold decision as resolved
    Per-user calibration by button is adopted, validated by the Campaign A / OE1
    re-don drift (8.0° pitch / 21.6° roll over 4 genuine re-dons). Condense the
    rationale, drop the preliminary/optional sections, and list what is still
    pending (physical button, ESB command, flash persistence).
2026-09-15 CLAUDE.md: sync to post-midterm state (chair PCB built, Campaign B done)
    - Chair MCU confirmed as a second XIAO nRF52840 Sense; record the built chair
    PCB (CD74HC4067 on C8–C15, 3.3 kΩ pull-down dividers, mux→XIAO pin map).
    - Analog-input facts (exactly A0–A5), mux-on-sense-side argument, R_fixed.
    - Status: Campaign B captured + validated (B1–B7), measured FSR floor and
    findings, FSR analysis tooling; midterm plan removed; current phase =
    chair-unit bring-up. Bring-up plan steps 1–2 done, 3–4 added.
    - Calibration open question closed (per-user calibration, alert on deviation).
2026-09-29 docs: add TASKS.md backlog with LiPo 3-wire battery hookup item
2026-09-29 docs: research LiPo 103450 battery hookup to XIAO; update TASKS
    Battery is a JYH LIP103450-1800 1S1P; 3rd wire is likely a 10k NTC the
    XIAO can't use. +/- only on BAT pads is safe, but the BQ25101 10 h safety
    timer caps a single USB charge at ~55 % (100 mA) of 1800 mAh.
2026-09-29 CLAUDE.md: trim to current state (8 FSRs, drop resolved questions and stale notes)
2026-09-29 CLAUDE.md: fold decisions into hardware section, replace status with pointers
    Move mux-placement, R_fixed, ESB and calibration decisions inline under
    Hardware; drop the long firmware/status/campaign sections in favor of a
    short "Where things are" index (TASKS.md, analysis/, docs/).
2026-09-29 docs: add 5-stage firmware roadmap to TASKS.md
    Chair FSR readout -> ESB link -> body IMU+motor -> fusion/classification
    -> integration/validation, each with a testable done criterion. Existing
    items move under a Backlog section.
2026-09-29 firmware: add chair FSR scan sketch (mux C8-C15, ratiometric ADC, CSV)
    Validated on the chair PCB: C8 and C10-C15 respond individually and read
    ~0 when open. C9 reads full scale due to a PCB short to 3V3 (tracked in
    TASKS.md).
    [chair.ino]
2026-09-29 firmware: ESB link chair -> body (nrf_to_nrf)
    Chair sends each 20 Hz scan (seq, cmd, 8 raw counts) and reports
    ACK/retransmit/latency stats; 'c' queues a calibrate command that repeats
    until ACKed. New body sketch receives, prints CSV and counts seq gaps.
2026-09-29 docs: close firmware stage 2; record ESB library and bench results
2026-09-29 docs: add missing chair calibration button to stage 1
2026-09-29 firmware: body IMU deviation alert (LED stands in for motor)
    Non-blocking 20 Hz IMU sampling, calibration from chair CMD_CALIBRATE or
    serial 'c', alert when deviation > 10 deg for 3 s (clears < 7 deg).
    CSV now carries cal/dev/alert/led state plus the last chair packet.
2026-09-30 firmware(chair): calibrate button on D9 with debounce; green LED on ACK
    Button to GND with INPUT_PULLUP and a 25 ms software debounce, polled
    while idling between scans. Serial 'c' still works. The green RGB LED
    (active LOW) flashes 300 ms when the calibrate packet is ACKed.
2026-09-30 docs: record calibrate button pin (D9) and remaining bench test
2026-09-30 docs: drop LED polarity caveat (active LOW confirmed on bench)
2026-09-30 analysis: live IMU plot of the body unit over serial
    Plots the current calibrated deviation (dpitch, droll) with a trail on
    top of the recorded posture clusters, the 10/7 deg alert/clear circles,
    and the firmware's alert/LED state. c/r keys calibrate/clear; --log
    saves the stream. Adds pyserial + PyQt6 (no Tk on this system).
2026-09-30 docs: stage 3 IMU alert validated; motor wiring and threshold retune remain
2026-10-02 firmware(body): drive vibration motor on D10 (PWM), LED mirrors; 'm' test buzz
    [body.ino]
2026-10-02 docs: record motor driver wiring (D10, NPN low-side, 3V3) and bench test
2026-10-03 firmware(body): soften motor buzz (MOTOR_DUTY 255 -> 30)
    [body.ino]
2026-10-03 docs: stage 3 done (motor validated); C9 short fixed; threshold retune moves to stage 5
2026-10-03 firmware(body): MOTOR_DUTY 30 -> 100 (tuned on bench)
2026-10-03 docs: stage 1 done (8 FSR channels + calibrate button validated)
2026-10-13 docs: record motor driver parts (BC337; diode likely 1N4148)
2026-10-13 docs: motor noise cap is 33 nF (333), not 100 nF
2026-10-15 firmware(body): MOTOR_DUTY 100 -> 200
2026-10-16 docs: AGENTS.md — no changes unless explicitly requested
2026-10-16 docs: AGENTS.md — suggestions welcome, ask before applying
2026-10-16 docs: AGENTS.md — PRs for non-trivial changes (review bots)
2026-10-16 docs: AGENTS.md — wait for and address the 2 PR bot reviews
2026-10-16 firmware: move the brain to the chair unit
    Swap the ESB roles: the body now transmits pitch/roll at 20 Hz and the
    chair receives, calibrates (button/'c' is now local), runs the alert rule
    and sends the decision back in the ACK payload. The body drives the motor
    and, after 1 s without ACK, falls back to the same rule using the last
    reference the chair sent.
    The protocol structs and the alert rule live in a shared library,
    firmware/libraries/PostureLink, so the chair's decision and the body's
    fallback can't drift apart (build with --libraries firmware/libraries).
    The chair prints one CSV with the same leading columns the body used
    (t_ms,cal,dev,alert,led,dpitch,droll,pitch,roll,seq) plus c8.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
2026-10-16 docs: AGENTS.md — chair is the brain, body transmits, link-loss fallback
2026-10-16 analysis: live_imu.py — show 'body silent' instead of freezing on the last sample
    When the chair reports seq=-1 (body link lost), hide the dot, grey the
    trail, blank dev/state/LED and show a banner, instead of leaving the last
    body sample (possibly ALERT / motor ON) on screen as if current. Recovers
    on the next valid row.
2026-10-16 docs: TASKS.md — track ESB retransmissions + body power work
2026-10-17 analysis: live_imu.py shows the chair FSRs and maps them in-app
    The chair firmware already streams c8..c15 (ohms) on every row; the live
    view now draws them next to the IMU panel: the chair from above (4 seat +
    4 backrest spots filled by load on a sqrt-scaled conductance ramp, centre
    of pressure, L/R and front/rear split per plate) and a 10 s trace per
    channel. FSR rows are kept while the body is silent too.
    Which channel sits where is built in the app: 'm' walks the 8 spots and
    assigns the channel whose conductance jumps when that sensor is pressed
    (dominant over the runner-up, held 0.4 s); clicking a spot re-maps just
    that one, clicking a trace assigns by hand. The map lives in
    analysis/c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
2026-10-17 analysis: live_imu.py re-reads the FSR unit on every (re)connect
    Opening the port doesn't reset the chair, so its '# unit=' header may have
    gone by (e.g. raw mode set from another session). Send 'uu' on connect:
    the mode is unchanged and the firmware prints the current header again.
2026-10-17 docs: guia-live-imu.md — how to run live_imu.py and map the chair FSRs
2026-10-17 analysis: rename live_imu.py -> live_posture.py
    It shows the chair FSRs and their mapping now, not only the IMU. The guide
    follows (docs/guia-live-posture.md).
2026-10-17 analysis: chair_map.json — FSR channel per chair spot, mapped on the real chair
2026-10-17 docs: TASKS.md — track lowering the link rate to 5–10 Hz
2026-10-17 docs: TASKS.md — consider a BLE beacon for wireless state monitoring
2026-10-17 analysis: live_posture.py drops the June reference-cluster overlay
    The clusters came from the bare-XIAO capture (no enclosure, no neck mount),
    which no longer represents the device. A new overlay will come from the
    full-system captures (TASKS.md, task 4). Removes the dependency on
    postures.py and the --ref option.
2026-10-17 archive: move midterm IMU/FSR analysis, data and protocols to archive/
    analysis/archive/, data/archive/, docs/archive/ hold the June 2026 work
    behind the partial report (bare-XIAO IMU run, FSR402 bench
    characterization), kept as-is for the final report. Each gets a README
    note; data/README.md restarts as the registry for full-system captures.
    Archived scripts read data/archive/ and write analysis/archive/figures/;
    postures.py now defaults to the IMU run (the newest-CSV default had been
    picking up an FSR file). All path references updated.
2026-10-17 docs: TASKS.md — task 4 writes the full-capture protocol (tag map, tag 9)
2026-10-17 archive: READMEs reflect the pinned IMU default CSV
2026-10-17 docs: TASKS.md — app/standalone item reflects the chair as the brain
2026-10-17 docs: TASKS.md — track a gentler motor alert pattern
2026-10-19 firmware: valid-ChairAck link freshness, non-blocking serial, honest link stats
    Body (link freshness): a radio ACK no longer renews the link by itself.
    Only an ACK carrying a ChairAck of the right size and sane contents
    (known flags, finite refs when CF_CAL) keeps link=1; empty/odd ACKs are
    counted as transport only and the fallback kicks in 1 s after the last
    valid one. The last valid ChairAck (and its reference) survives for the
    fallback. LinkWatch goes down by state, so it is millis()-rollover safe.
    Serial (both units): every line goes through PostureLink/SerialOut.h:
    built in a fixed buffer (no heap), written whole and only if
    availableForWrite() can take it, so TinyUSB's write() never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
2026-10-19 docs: host tests, non-blocking serial output, flash both boards
2026-10-19 chair: only new samples keep the body link up; sketch integration tests
    pollRadio() refreshed lastBodyAt for duplicate/stale packets too, so a
    stream of them held bodyUp (and a stale CF_ALERT in the ACK payload)
    without any new decision. Now only accepted samples refresh it, and a
    timed-out link is declared lost (alert cleared, capture aborted) before
    a late packet is classified, so the cleanup can't be skipped by one
    arriving right at the timeout.
    SeqTracker docs: reboot detection is best effort (1-byte boot id ->
    1/255 collisions, then seq heuristics), not exact.
    Tests: chair.ino and body.ino now also run on host stubs (fake radio,
    USB serial, IMU): dups/old > 1 s drop the link and abort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
2026-10-19 firmware: ESB protocol v2 — body reports applied control, decisions carry their basis
    Both payloads start with a version byte (PROTO_VER = 2) at a fixed size;
    v1 payloads are rejected both ways (flash both boards).
    - ChairAck (15 B): calId (reference id, random start per chair boot, new
    on every capture/clear) and basis boot/seq = the body sample the
    decision was made on; boot 0 = not made on a sample (chair boot, link
    timeout, calibration cleared).
    - BodyPacket (18 B): what the body applied at its previous sample (ctl
    none/chair/fallback, cal, calId, alert), motor output and motor-test
    flags at send time, and the held decision's basis + age in body samples
    (never another boar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
2026-10-19 firmware/test: v2 telemetry tests, two-board system test
    - test_posturelink: payload validation (v1, version, coherence, ranges)
    and decision age (0, SEQ_MAX_GAP, rejection, wrap, repeated basis,
    no-basis ACK, saturation over > 65536 samples).
    - test_chair / test_body: ACK basis and calId, report columns, rejected
    packets don't renew the link, manual test vs alert, widest rows and
    stats lines at t_ms = UINT32_MAX through the 256 B FIFO.
    - test_system: chair.ino + body.ino together over a linked fake radio,
    unrelated clocks: decision N -> applied at N+1 -> reported in N+2,
    every report joined to its deciding row, fallback in/out, outage
    recovery. Dumps both serial streams for th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
2026-10-19 live_posture: read columns from the header, show the body's applied state
    Columns come from the firmware's header line (v1 layout until one is
    seen, so older firmware and logs still parse). The status box shows the
    chair's decision and the body's report: chair/fallback, age, and ✓/≠
    only when the deciding row (seq == bseq) is found in the same body
    session with seq stepping forward — otherwise 'unconfirmed'. Fallback is
    never called a mismatch; motor shows alert vs test. A 'bad=' count with
    no body samples asks to flash both boards.
    test_live_posture.py runs firmware/test/test_system and parses its real
    chair output, plus v1 rows and the confirmation edge cases.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
2026-10-19 docs: ESB protocol v2 telemetry, flash both boards, live view status
2026-10-20 chair: keep FSR serial columns in raw ADC units
2026-10-20 firmware: report IMU validity and inhibit stale posture alerts
2026-10-20 live_posture: show IMU faults and inhibited control
2026-10-20 docs: describe protocol v3 IMU recovery and bench checks
2026-10-20 body: avoid restarting PWM for unchanged motor output
2026-10-20 firmware: preserve invalid IMU telemetry under board fast-math
2026-10-20 live_posture: posture tags 0-9 in the capture log
    Keys 0-9 set the current posture tag (0 = transition, the default, so
    untagged data is dropped). With --log every data row gets it as a last
    `tag` column; tag names come from analysis/tags.json and go into the log
    as a `# tag map` line. The status box shows the active tag.
2026-10-20 docs: full-system capture protocol (IMU + 8 FSRs)
    Tag 0 = transition; postures 1-9 (incl. leg variations) are defined in
    run 1 and fixed after it. Marked + subtle series in shuffled order,
    re-don block and an optional free-use block.
2026-10-21 body: charge the LiPo at 100 mA (P0.13 LOW)
    The core leaves P0.13 floating (50 mA). With the BQ25101's ~10 h safety
    timer, 100 mA fills ~55 % of the 1800 mAh cell per USB session vs ~28 %.
2026-10-21 tasks: LiPo hookup done; keep the P0.14 note under integration
2026-10-21 body: drive VBAT_ENABLE (P0.14) LOW at boot
    The Seeed core sets it HIGH in initVariant(), leaving the VBAT sense pin
    (P0.31) near 3.6 V, above its limit, mostly while charging. LOW keeps it
    at ~Vbat/3 and enables battery-voltage reading; costs ~2.8 uA.
2026-10-21 analysis: chair_map.json — definitive FSR channel per chair spot
2026-10-21 firmware: RGB status LED on both boards
    Both XIAOs now show the system state on the onboard RGB LED (shared
    PostureLink/StatusLed.h, PWM so orange is a red/green mix):
    orange = no link, blue = linked, green = calibrated,
    green fast (chair) = capturing the reference,
    red slow = posture alert (body: in step with the motor),
    red fast = radio init failed / IMU silent for 250 ms.
    The body LED is dimmed to 1/8 for the LiPo; the chair runs at full
    brightness. The chair's one-shot green flash on capture is gone (green
    now stays on). setLed/ledState on the body become setMotor/motorOn: the
    red LED no longer mirrors the motor directly.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
2026-10-21 chair: radio gap no longer blinks as an IMU fault
    The IMU-fault test measured time since the last valid sample, so any
    silence before the 1 s link timeout blinked fast red for ~750 ms. Measure
    the invalid span across received samples instead (lastBodyAt - imuOkAt);
    test_system checks the first 900 ms of an outage stay green.
2026-10-21 StatusLed: more green in orange ({255,40,0} looked red on the board)
2026-10-21 firmware: pick boards by USB serial, not ttyACM number
    ttyACM0/1 swap between plugs, and chair firmware flashed onto the body
    runs the motor at full power (mux S0 = the body's motor pin D10). Document
    each board's USB serial and upload through readlink -f of its by-id path
    (the symlink itself fails the DFU upload). Note that the occasional
    "Target is not in DFU mode" just needs a re-run.
2026-10-21 body: restart the 16 MHz crystal if USB unplug stops it
    TinyUSB stops the HFXO on USB removal (dcd_nrf5x.c, USB_EVT_REMOVED ->
    hfclk_disable); nrf_to_nrf only starts it in begin(). On the internal RC
    clock the radio is off frequency, so unplugging USB while on the LiPo
    dropped the link until a reset. loop() now restarts it when it is not
    running from the crystal.
2026-10-21 body: low-battery cutoff, System OFF, watchdog; vbat in ESB proto v4
    - PostureLink/Battery.h: VBAT conversion (internal 0.6 V ref, 0..1.8 V,
    12 bit, nominal 1510/510 divider, calibration formula) and the cutoff
    rule: 3 readings in a row < 3.30 V on battery (reset above 3.35 V),
    boot on battery needs >= 3.40 V, never on USB, implausible < 2 V ignored.
    - body.ino: reads VBAT every 2 s only after the motor rested 200 ms;
    cutoff = motor + radio off, 3 dim magenta blinks, IMU unpowered,
    System OFF. Boot check before anything else. 4 s WDT fed every loop().
    Header gains resetreas and vbat/usb lines; CSV gains vbat.
    - Protocol v4: BodyPacket + uint16 vbat (21 bytes); chair CSV gains vba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
2026-10-21 live_posture: show the body battery (vbat) and a cutoff hint when silent
2026-10-21 docs: body battery protection (AGENTS, TASKS, live-view guide, research)
2026-10-21 body: battery reading waits for the real motor-off time; I2C pull-ups off before System OFF
    - checkBattery() takes a fresh millis(): sample()'s radio.write() can run
    past loop()'s t, so a motor that went off after t looked rested (unsigned
    wrap) and a reading could catch its sag. BatteryMonitor::due() also uses
    the signed distance. Test: a buzz ending on a sample iteration whose
    write() takes 5 ms (stub radio can now advance time).
    - powerOff(): Wire1.end() leaves begin()'s SDA/SCL pull-ups on, which would
    back-power the unpowered IMU in System OFF; set both pins to plain INPUT.
    Addresses CODEX-01, CLAUDE-01.
2026-10-21 Battery: bounded stale-t window instead of a signed rest check
    The signed check stopped all VBAT readings (and so the cutoff) after
    2^31 ms (~24.8 days) without the motor. Now: not rested if
    t - motorOffAt < 200 ms, or motorOffAt is at most 1 s after t (stale t);
    anything else is a long rest. Tests at and past 2^31.
    Addresses CLAUDE-02.
2026-10-21 docs: chair uses one shared 3.3k pull-down on SIG; update unit status
    The final chair board has a single 3.3 kOhm resistor from the mux SIG to
    GND instead of one divider per channel, so the mux R_on (~100 Ohm) now sits
    in series with each FSR. Document the topology, why R_on is acceptable
    (absorbed by per-user calibration, small vs FSR402 spread, >=400 Ohm floor
    under body load) and how R_fixed was chosen.
    Status: body unit finished and running on its LiPo; chair electronics
    finished, battery (same circuit as the body) still to be tested.
2026-10-21 chair: drive VBAT_ENABLE LOW at boot for the LiPo
    The chair now runs on the same LiPo circuit as the body. The core drives
    P0.14 HIGH at boot, leaving P0.31 above its limit while charging; mirror the
    body's fix.
2026-10-21 chair: keep the radio crystal on and charge at 100 mA on the LiPo
    Mirror the body: TinyUSB stops the 16 MHz crystal when USB is unplugged,
    leaving the radio on the RC clock (link drops until reset), so restart it
    from loop(). Drive P0.13 LOW for 100 mA charging of the 1800 mAh pack.
    The chair test now checks both battery pins after setup().
2026-10-21 live_posture: show the current tag as a big badge on the IMU plot
    Flashes a green border on each tag key so the press is confirmed.
2026-10-21 body: alert buzz at full duty, 700 ms on / 300 ms off
    MOTOR_DUTY 200 -> 255 and PULSE_ON_MS 300 -> 700 (period stays 1 s).
    The chair's alert LED keeps the same rhythm as the motor.
2026-10-21 body: MOTOR_MUTED build flag for data captures
    The buzz shakes the IMU; the capture build holds the PWM at 0 while the
    alert logic, LED and logged motor state stay as usual. Default unchanged.
2026-10-22 data: run 1 captures (4 subjects, marked series, 1 pass)
    Andre, Felipe, Thiago and Vinicius on 2026-10-21, IMU + 8 FSRs, tags 1-9
    in order. Felipe's second tag-3 block retagged to 4 (escorregado, mistag
    during capture).
2026-10-22 analysis: captures.py, loader for the full-system runs
    Parses a data/ capture: rows, '#' events in stream order, fsr map -> spot
    names, tag map, calibrations with their 1 s capture window (19 rows before
    the '# calibrated' event + the first row with the new calid, as in
    chair.ino), tag segments and settled samples.
2026-10-22 analysis: IMU + FSR fusion alert rule, replay and LOSO evaluation
    fusion.py: the per-sample decision (decide(), port 1:1 to C++) + the timing
    gate, replay of the 9 runs, current vs fusion tables per tag x subject, and
    a leave-one-subject-out grid search. Seat-rear load (vs the per-user
    calibration baseline) flags escorregado and exempts reclinado's backward
    tilt; seat L/R shift confirms small leans; an empty seat never alerts.
    test_fusion.py: loader, rule, gate, replay == logged firmware alert.
2026-10-22 docs: decisão da regra de alerta com fusão IMU + FSR
    Rule (pseudocode, thresholds and their data justification), current vs
    fusion per tag x subject, LOSO results, known failures, legs-crossed
    detectability and the empty-seat handling.
2026-10-22 analysis: gate in integer ms, C++ cross-check fixture, new log columns
    The Python gate now counts chair millis() like the MCU (no float rounding at
    the 3 s hold). fusion.py --fixture writes real log excerpts replayed by the
    rule (firmware/test/fixtures/fusion_cases.txt) for the C++ port to match;
    a test keeps it in sync. captures.py reads the chair's new reason column
    and its logged FSR baseline (fsr= in '# calibrated upright:').
2026-10-22 PostureLink: Fusion.h, the chair's IMU + FSR alert rule
    decide() + FusionGate, 1:1 with analysis/fusion.py (same thresholds, order
    and reason codes). AlertGate stays for the body's IMU-only fallback.
    test_fusion: unit cases + the Python fixture replayed with identical
    reason codes and alerts (2240 rows, 0 mismatches).
2026-10-22 chair: decide the alert with the IMU + FSR fusion rule
    The FSR baseline is captured over the same CAL_SAMPLES as the IMU reference
    (logged as fsr= in '# calibrated upright:') and cleared with 'r'. Spots map
    to channels through FSR_SPOT_CH (copy of analysis/chair_map.json). New last
    CSV column reason (Fusion.h code, -1 = no decision). ESB protocol unchanged.
    Host stub: optional per-read ADC hook; chair/system tests run seated.
2026-10-22 docs: chair alert is the IMU + FSR fusion rule
2026-10-22 PostureLink: alert gates hold correctly at t = 0 and across the millis() wrap
    AlertGate (body fallback) and FusionGate used overSince = 0 as 'no hold'
    and stored 1 for t = 0, so 0 - 1 passed the hold at once: an alert on the
    first over-threshold sample at millis() == 0 (boot, or the 32-bit wrap). A
    separate 'holding' flag replaces the sentinel and the hold is a u32
    difference (millis() width on the nRF52; the host's 64-bit unsigned long
    hid the wrap). Tests at t = 0 and across the wrap for both gates. The Python
    Gate already used None, no change there.
2026-10-22 analysis: don't reconstruct a calibration baseline from an incomplete window
    The chair drops whole rows/events when the USB host lags (sdrop/edrop), so
    the 19 rows before '# calibrated' can reach back into other postures. A
    window is now only used if '# calibrating' sits right before it, the body
    seq is consecutive in one session, the IMU valid and the calid sequence as
    expected; otherwise a warning, Cal.trusted = False and its rows are left out
    of the replay/evaluation. The chair's logged fsr= baseline is used as is.
    All 9 runs pass the check (evaluation unchanged).
2026-10-22 chair: reject a calibration with the seat rear unloaded
    Calibrating perched forward (or on an empty chair) gave a ~0 seat-rear
    baseline, which silently turned slump detection off. The capture is now
    rejected like an aborted one (previous state kept): '# calibrate rejected:
    seat rear unloaded (sit back fully and recalibrate) rear=N' and the LED
    blinks red fast (the fault pattern) for 2 s. decide()'s zero-baseline
    guards stay as defence in depth. Python: FusionRule.calibrate() refuses the
    same captures (reject_cal; the replay leaves those rows uncalibrated) - only
    the empty-chair pre-log calibrations of 3 runs, all untagged, so the
    evaluation is unchanged; the C++ fixture gains 3 empty-seat ex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
2026-10-22 analysis: score only rows with a valid calibration
    Rows whose calibration is untrusted or missing (NaN baseline) were still
    scored: a bad posture there counted as a miss, an ok one as quiet,
    skewing the tables and the LOSO selection. Inputs.valid (calibrated with a
    trusted baseline) now gates seg_table(): fractions, counts, 'fired' and
    latency use valid rows only, and a segment with no valid settled row is
    left out. Test: a run with a dropped capture window followed by settled
    postures takes no part in scoring or selection. 9-run numbers unchanged.
2026-10-22 analysis: freeze the replay gate on every capture, as the chair does
    The chair skips decisions for the whole capture (calLeft > 0), whatever its
    end: calibrated, rejected, aborted, link lost or cleared; a repeated
    '# calibrating' restarts it. captures.find_captures() records them all
    (first '# calibrating' to the event that ends it) and inputs() freezes
    those rows, with no reference/baseline change unless a '# calibrated'
    follows. replay_v() now skips frozen rows like the sequential replay, so a
    hold running before a rejected capture carries over it. Tests: a rejected
    capture mid-posture, and test_chair's fusion scenario (written by
    './test_chair <file>') replayed: identical alert on every r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
2026-10-22 analysis: don't score rows under a baseline the chair would reject
    Older logs can hold a calibration with the seat rear unloaded; FUSION is
    forced quiet there while CURRENT decides, so neither rule is scored on
    those rows. No effect on the 9 runs.
2026-10-22 docs: capture protocol — short version with shuffled-order sheet
    Documents the ~12 min protocol actually used on 21-22/10 (sheet P1-P8:
    passes A/B, subtle, re-placement) and keeps the full one as optional.
    Adds what changed since: FSR map check against FSR_SPOT_CH, muted-motor
    build for data, one new log file per session, calibration rejected off
    the seat's rear, ereto between postures, hips back after `4`.
2026-10-22 docs: crossed legs don't alert (decision closed)
2026-10-22 live_posture: PT-BR UI for the science fair, tag only with --log, recorded postures back on the IMU plot
    - All on-screen text in Portuguese (status box, banners, chair panel,
    FSR mapping prompts, slot names); voltages/deviation with a decimal comma.
    The log format is unchanged (tag 0 is still "transition" in # tag map).
    - The tag badge, the tag line and the 0-9 keys only exist with --log.
    - The IMU plot again shows the recorded postures, now from the 2026-10-21
    full-system captures: per-subject medians + group median, red = should
    alert (fusion.BAD_TAGS), green = must not; --no-ref hides them.
    - Axis labels fixed for the neck mount: dpitch = sideways lean (− left),
    droll = forwar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
2026-10-22 live_posture: reference overlay can't crash startup; one dot per subject
    - Load the reference captures before the --log file is created, skip the
    active log by path, and skip any unreadable capture (a log cut short
    before its first row) instead of exiting.
    - Fixed set: the 2026-10-21 tagged captures, so new logs don't shift it.
    - Pool each subject's runs: André's run1 + run2 are one dot, matching the
    "N pessoas" legend.
2026-10-22 live_posture: FSR mapping only with --fsr-placement; tag badge times the hold
    The FSRs are soldered, so m / click-to-map are off unless --fsr-placement.
    The tag badge now counts down the hold (15 s, --hold; 10 s for upright
    between postures, as in the capture protocol) and turns green when done;
    transition (0) shows a stopwatch.
2026-10-22 mostra: fullscreen exhibit view for the science fair
    analysis/mostra.py reads the same chair stream as live_posture.py, made
    for visitors (PT-BR): a status band with icon + label (good / attention /
    alert, with the posture's name from the fusion `reason`), the deviation
    target with the recorded postures, the chair pressure, how it works, the
    current visitor's numbers + a 2-min timeline, and the day's numbers.
    High turnover: a visit starts at a calibration (button / c / space) and
    ends after the seat stays empty 10 s (or n). The chair's calibration is
    then cleared so the next person isn't buzzed against someone else's
    reference (--keep-cal skips it). Day numbers persist per date.
    --replay pl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
2026-10-22 mostra: replay keeps day numbers in memory; leaving breaks the streak; timeline resets on a time jump
    Review round 1 (PR #12): a --replay no longer adds recorded visits to the
    real day's saved numbers; any non-good sample (away, invalid IMU) resets
    the 'sem parar' streak; t_ms going backwards (chair reset, replay loop)
    clears the timeline instead of letting it grow.
2026-10-22 docs: stand design guide for the science fair, with the printed panels
    Palette, typography and visual language sampled from the two stand panels,
    plus a (not applied) proposal to align mostra.py with them.
2026-10-23 firmware: runtime motor mute for data captures (ESB protocol v5)
    The chair's 'q'/'v' set CF_MUTE in the ChairAck; the body then keeps the
    motor PWM at 0 on alerts while the chair keeps deciding and logging. The
    motor test still buzzes, the fallback keeps the mute held, and nothing is
    saved: a reboot or the USB host closing the chair's port unmutes. The body
    reports BF_MUTE; new columns: chair mute,bmute, body mute. `motor`/`bmotor`
    still mean "would buzz". Replaces the MOTOR_MUTED build flag.
2026-10-23 live_posture: --motor-muted sends 'q' on every connection
    The status box shows "mudo" / "mudo (teria vibrado)" from the body's bmute
    report, and a banner warns when the chair doesn't confirm the mute.
2026-10-23 docs: captures use --motor-muted instead of a muted body build
2026-10-23 mostra: align the exhibit screen with the stand's visual identity
    Visual only (visits, stats and decisions untouched):
    - navy text/titles, upper-case section titles, Noto Sans (DejaVu fallback
    for the symbols); lavender background, white cards; step numbers in
    #1e71e4; FSR pressure cyan -> violet.
    - Status band: the stand's green/pink stepped down for white text
    (#2e9e64 3.4:1, #c2416f 4.9:1); amber attention kept, navy text (6.3:1);
    neutral states on the stand gradient #1e71e4 -> #9142d4 -> #cd4fd3.
    - Fixes: "escorregado"/"reclinado" and "cabeça p/ frente"/"inclinado à
    dir." labels no longer touch; "Média do dia" fits its card; tighter step
    text for Noto's line height.
    - Rege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
2026-10-23 body: hold the last quiet IMU reading while the motor runs
    The buzz shakes the IMU about ±10° in its first ~100 ms. In the 2026-10-22
    validation (Lucas-Santos) a shaken sample under CLEAR_DEG cleared a held
    inclinado_esq alert 6 times: one short buzz every ~3.5 s instead of the
    pulse. While the PWM runs, the body now sends (and logs) the last reading
    taken with the motor off, for at most SHAKE_HOLD_MAX_MS = 1 s. The chair
    rule and the analysis replay are unchanged.
    Replaying the validation logs with the angles held: Lucas 5 alerted 9 % ->
    100 %, crossed legs 8 % -> 11 %; Andre unchanged. A clear hold in the gate
    was tried first and dropped: any hold made the borderline LEAN alerts on
    cros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
2026-10-23 body: shake hold up to 1.5 s (a motor test can run into a pulse); wording
2026-10-23 mostra: read the chair wirelessly and tolerate sparse BLE samples
2026-10-23 docs: explain wireless exhibit setup and measured BLE reception
2026-10-23 mostra: wait 5 s of BLE silence before showing the chair disconnected
    The 2 s timeout flagged lost connection too often. A separate
    DISCONNECT_S (5 s) now drives the disconnected state, the auto USB/BLE
    fallback and the FSR 'live' check; SILENT_S (2 s) still bounds the
    lost-packet count and the tolerated sample gap in the stats.
2026-11-08 docs: close the firmware roadmap after the science fair
    Fusion validated informally with dozens of people at the fair, chair
    battery and body low-battery cutoff verified, BLE dashboard in use.
    Record the autonomous + dashboard decision and drop the done tasks.
2026-11-08 analysis: generate the final report's results figures
    report_figures.py builds report/figures/res_*.png (PT-BR, grayscale-safe)
    from captures.py/fusion.py: IMU and seat indices per posture/subject,
    per-subject alert heatmap, ablation and the 2026-10-22 validation timelines.
2026-11-08 report: first full draft of the final report
    relatorio_final.tex + chapters in report/final/: introduction and review
    from the delivered version (review extended with sensors, related work,
    haptic feedback and thresholds; BackWatch reference completed — FEBRACE
    2025 poster), methods for the integrated system, results (bench, 21/10
    captures, fusion/LOSO, 22/10 hardware validation, fair, link/energy),
    discussion, conclusion and abstract. Remaining \pendente{} markers: cover
    data, flyback diode, current/autonomy.
2026-11-08 report: state the crossed-legs false-alert rate in the conclusion
    The 3% LOSO figure covers upright/reclined only; crossed legs reached 28%.
2026-11-08 report: IMT (abnTeX2) delivery version of the final report
    University template (Instituto Mauá) in report/imt/, condensed from the
    long version to 14 text pages (limit 15): methodology split into
    Colar / Cadeira / Integração with TikZ flowcharts and block diagrams
    (advisor's request); tests, results and discussion in chapter 4; review
    condensed with a BibTeX file (31 sources + 6 component datasheets, all
    checked). Template fixes: \input instead of \include (labels were lost
    with \clearpage disabled), explicit page breaks after the front matter,
    "Fonte" caption after the English abstract.
2026-11-08 report: version the IMT page-count script
    paginas.py compiles report/imt with Tectonic (PATH or TECTONIC) and prints
    where each chapter starts; CONVENCOES.md now points to it instead of a
    session scratchpad path.
2026-11-08 report: add collar and chair schematics to the IMT methodology
    Draw both circuits with circuitikz (XIAO pins, BC337 motor driver with
    flyback diode and 33 nF, CD74HC4067 with the 8 FSR402 and the shared
    3.3 kOhm pull-down, calibrate button, LiPo) and shorten the prose that
    described the wiring in words. Note that the collar enclosure takes the
    1800 mAh cell.
2026-11-08 report: reframe sample and energy limits in the IMT version
    Report the Eureka exhibition qualitatively (150+ visitors of varied
    builds, detection in practically every observed case) and the collar's
    observed autonomy (600 mAh cell for the ~20 h of the two days, so mean
    current <= 30 mA, >= 60 h with the 1800 mAh cell). Drop "small sample"
    and "unmeasured consumption" as headline limitations in the conclusion
    and abstracts; keep the instructed-posture and no-health-effect caveats.
2026-11-08 report: fix flyback diode polarity and qualify exhibition claims
    Draw D1 with its cathode at 3V3 in the collar schematic (it was reversed).
    Present the 1800 mAh runtime as a proportional extrapolation, not a
    measurement, and mark the exhibition's consistent detection as a
    qualitative observation in both abstracts.
2026-11-08 report: bring the IMT resumo back under 1160 characters
    Tighten wording (qualitative-observation caveat kept); 1141 rendered
    characters.
2026-11-08 report: fill IMT cover and add power switch + 1N4148 to the schematics
    Cover: group members, advisor (Profa. Me. Andressa Corrente Martins) and
    both courses, from the pre-banca delivery. Schematics: on/off switch S1
    between the LiPo and BAT+ on both units, flyback diode identified as
    1N4148 (capacitor in parallel with the motor confirmed).
2026-11-08 analysis: add pitch/roll posture-dispersion figure for the report
    res_dispersao_posturas.png: stable samples of the 21/10 captures, one
    colour per posture with mean ±1σ, (a) absolute angles and (b) calibrated
    deviation (final axis convention: Δpitch lateral, Δroll sagittal). Shows
    the per-person spread removed by calibration and the slump/reclined
    overlap that the IMU alone cannot resolve. Also enlarge the fonts of
    res_alerta_sujeitos.png for print.
2026-11-08 report: condense the IMT version to 15 pages in total
    The advisor counts the 15-page limit over the whole PDF (cover, abstracts,
    text and references). 20 -> 15 pages:
    - Ch. 1/2/5 tightened; review merges posture/assessment sections, drops
    the comparison table and peripheral citations (37 -> 22 references).
    - Ch. 3 drops the FSR map figure, the chair-cycle flowchart and the
    constants table (values live in the fusion flowchart); keeps 3.1/3.2/3.3,
    both schematics and the collar/architecture/fusion diagrams.
    - Ch. 4 turns the posture table into prose, trims bench/ablation/
    discussion and adds the pitch/roll dispersion figure as the IMU-only
    motivation for fusion.
    paginas.py now report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
2026-11-08 docs: record the 1N4148 flyback diode and the battery on/off switch
    Confirmed by the user: the body's flyback diode is a 1N4148 and the
    33 nF sits across the motor; both units have an on/off lever switch on
    the LiPo + lead before BAT+.
